arctic-trail/arctic-trail-cam/pi-diode-trailcam/docs/images/real_build/stage2_05_bench_overview_boxes_and_boards.jpg

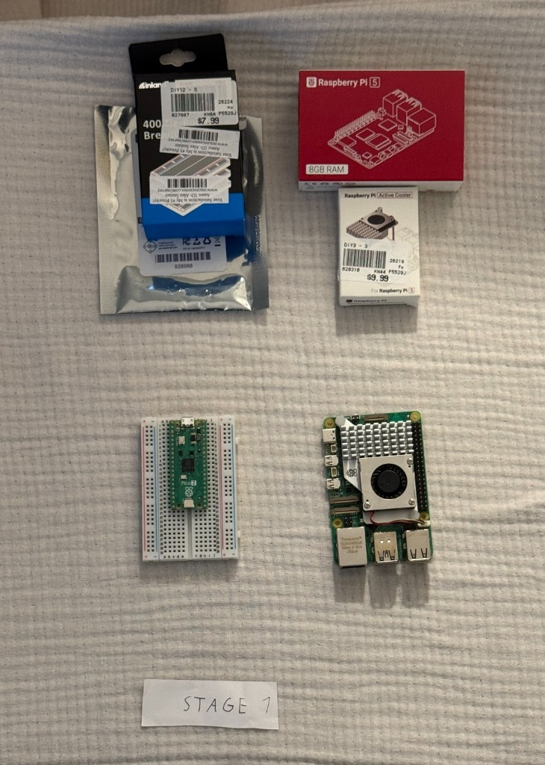
pi-diode-trailcam/docs/images/real_build/stage2_05_bench_overview_boxes_and_boards.jpg
