arctic-trail/arctic-trail-cam/pi-diode-trailcam/hardware/turnkey_assembly_package/BOM-jlcpcb.csv

Comment | Designator | Footprint | LCSC Part #
HT7533-1 30V 3.3V Low-Iq LDO | U1 | SOT-89 | C14289
2x20 Pin 2.54mm Female Socket (for Pico) | U2 | Header-1x20-P2.54mm_x2 | C22557
TPS54560BDDAR 60V 5A Buck | U3 | SOIC-8-EP | C31966
ADS1115IDGSR 16-Bit ADC | U4 | VSSOP-10 | C37593
AO3401A 30V P-FET | Q1 Q3 | SOT-23 | C15127
AOD403 30V 70A High-Side P-FET | Q2A Q2B | TO-252 | C15075
MMBT2222A 40V 600mA NPN Transistor | Q4 Q5 | SOT-23 | C8512
SMBJ15CA 600W TVS Diode | D1 | DO-214AA_SMB | C319205
USBLC6-2SC6 ESD Protection Array | D2 D3 D4 D5 | SOT-23-6 | C7519
SS54-E3 40V 5A Schottky Diode | D6 | DO-214AB_SMC | C22432
10uH 6.5A Shielded Power Inductor | L1 | IND-SMD_10x10mm | C497818
10uF 50V X7R 1206 Ceramic Cap | C1 C2 | C_1206 | C13585
47uF 16V X5R 1206 Ceramic Cap | C3 C4 | C_1206 | C172351
0.1uF 50V X7R 0603 Ceramic Cap | C5 C6 C7 C8 C9 | C_0603 | C14663
10nF 50V X7R 0603 Ceramic Cap | C10 | C_0603 | C1588
10k 1% 0805 Resistor | R1 R6 R7 R8 | R_0805 | C17414
1k 1% 0805 Resistor | R2 R9 R10 | R_0805 | C17513
4.7k 1% 0805 Resistor | R3 R4 | R_0805 | C17673
53.6k 1% 0805 (5.1V Upper FB) | R5 | R_0805 | C17739
100k 1% 0805 (Buck Freq RT) | R11 | R_0805 | C17417
220R 2A Ferrite Bead 0805 | FB1 FB2 FB3 | L_0805 | C1017
Micro-Fit 3.0 2-Pin RA Header | J1 J7 | CONN-TH_2P-P3.00mm | C2892976
Micro-Fit 3.0 4-Pin RA Header | J2 J3 J4 | CONN-TH_4P-P3.00mm | C2892978
USB-C Receptacle High-Power (5V 5A) | J5 | USB-C-SMD | C165948
DC Barrel Jack 2.1x5.5mm SMD | J6 | DC-005_SMD | C136657
2-Pin 5.08mm Screw Terminal | TB1 | TERM-5.08mm-2P | C474952
