arctic-trail/arctic-trail-cam/pi-diode-trailcam/docs/images/real_build/stage1_01_unboxed_parts.jpg

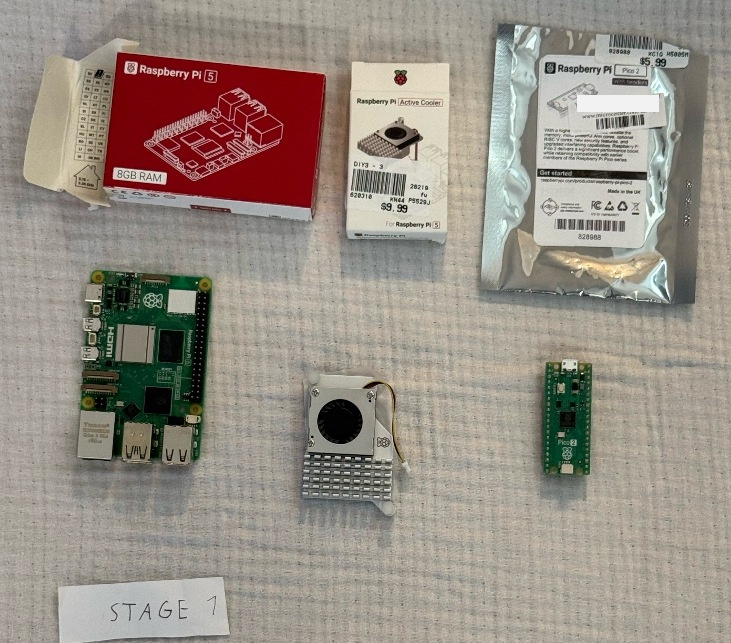
pi-diode-trailcam/docs/images/real_build/stage1_01_unboxed_parts.jpg
