arctic-trail/arctic-trail-cam/pi-diode-trailcam/docs/images/flashing_steps/step01_device_select.png

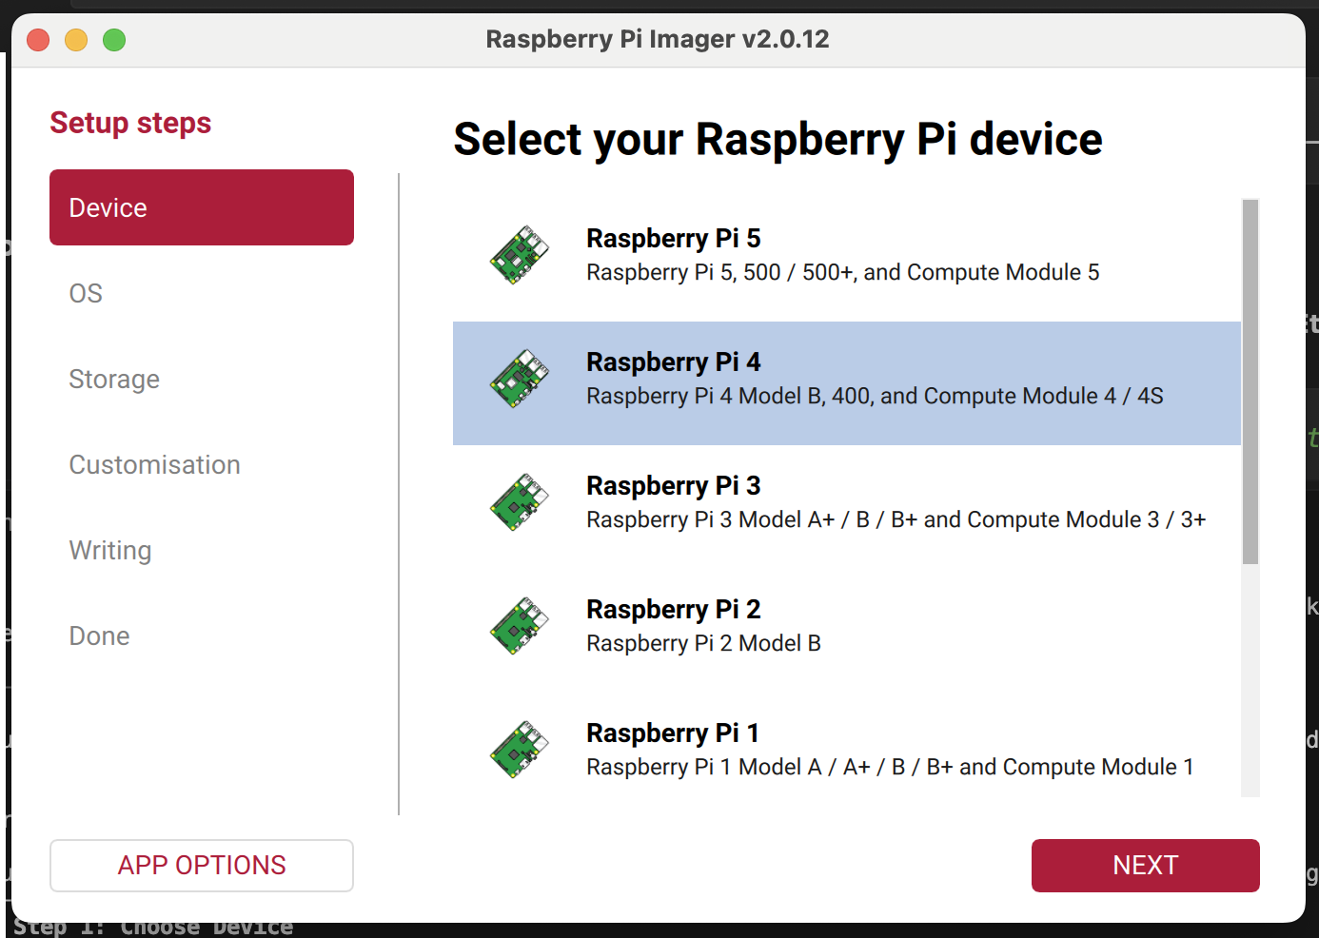
pi-diode-trailcam/docs/images/flashing_steps/step01_device_select.png
