arctic-trail/arctic-trail-cam/pi-diode-trailcam/docs/images/flashing_steps/step02_os_menu.png

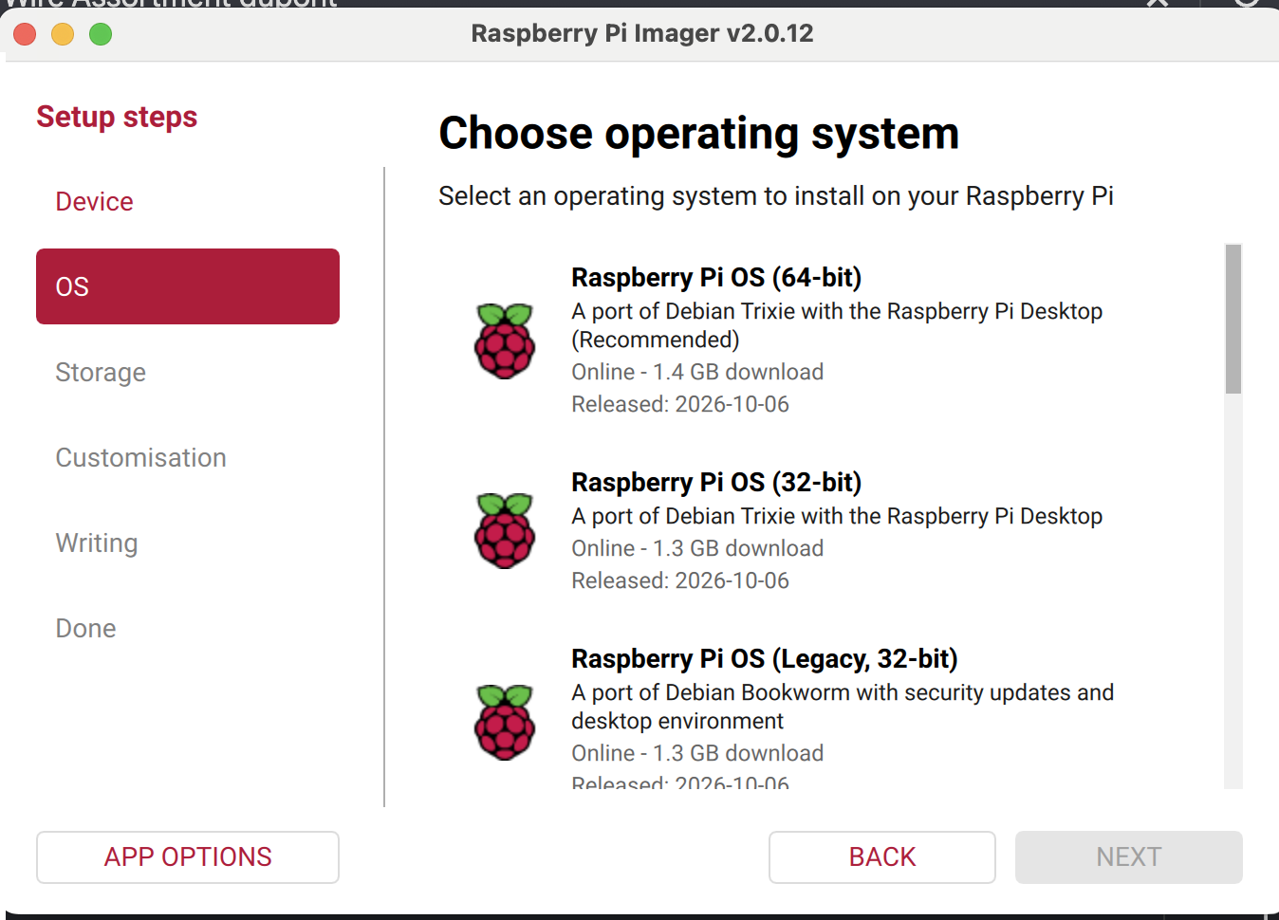
pi-diode-trailcam/docs/images/flashing_steps/step02_os_menu.png
