arctic-trail/arctic-trail-cam/pi-diode-trailcam/docs/images/flashing_steps/step03_os_other.png

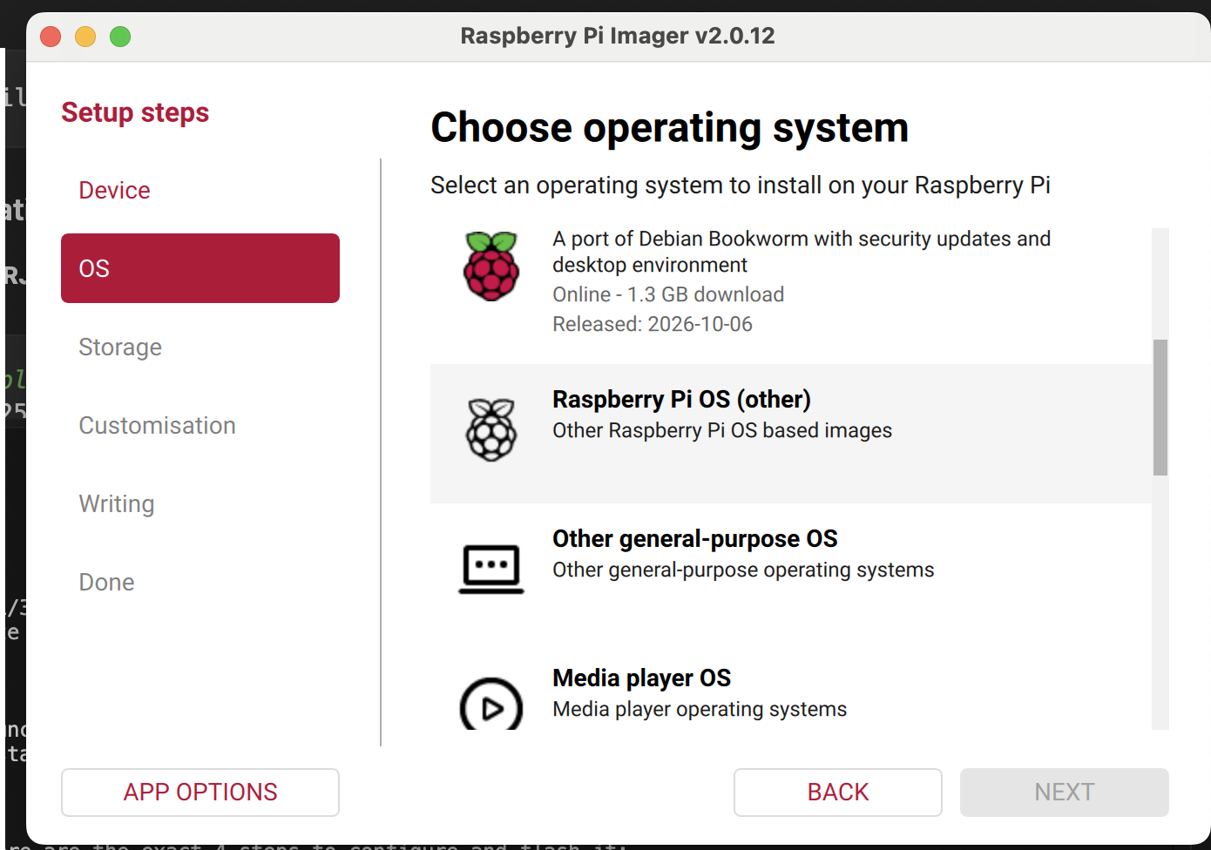
pi-diode-trailcam/docs/images/flashing_steps/step03_os_other.png
