arctic-trail/arctic-trail-cam/pi-diode-trailcam/docs/images/flashing_steps/step04_os_lite_64bit.png

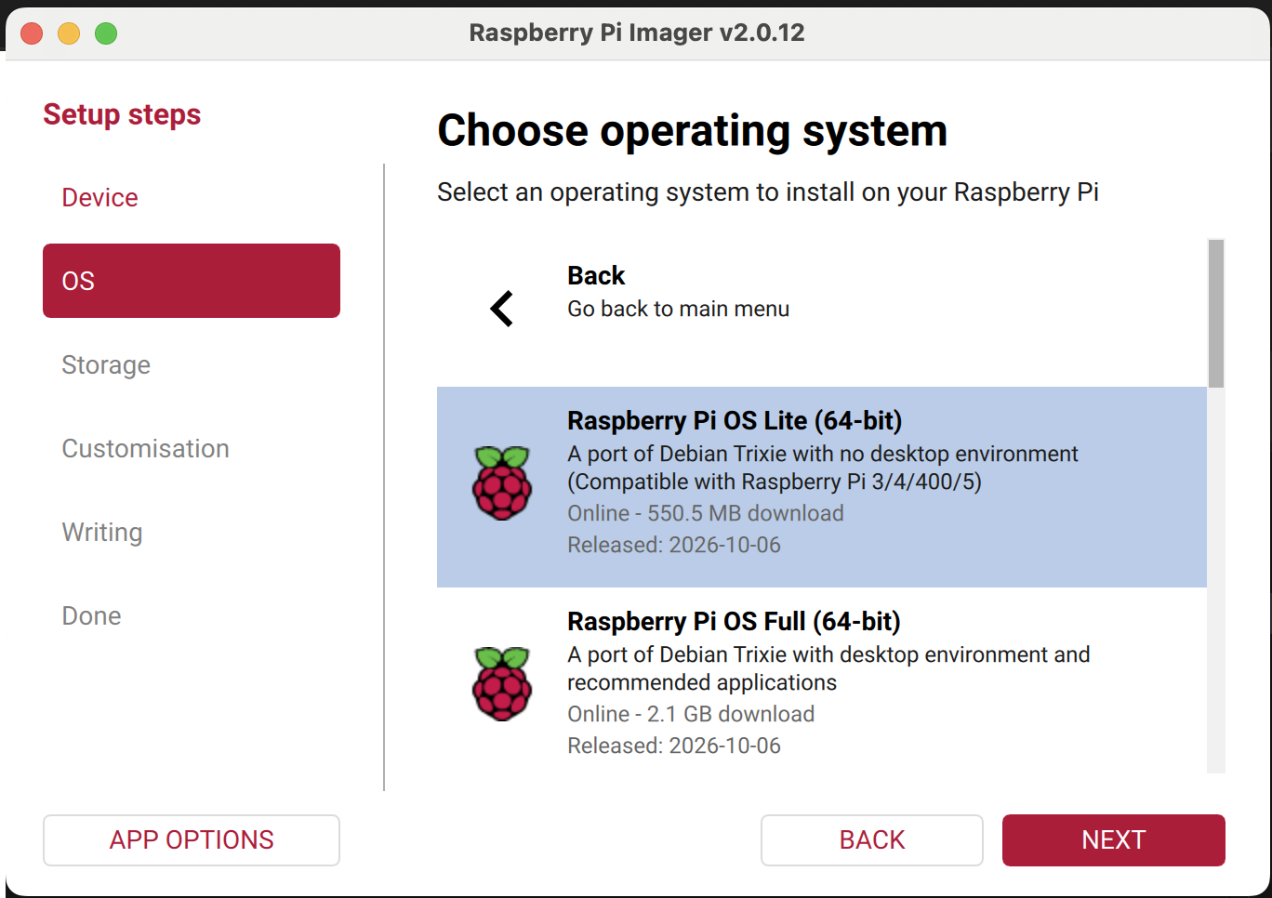
pi-diode-trailcam/docs/images/flashing_steps/step04_os_lite_64bit.png
