arctic-trail/arctic-trail-cam/pi-diode-trailcam/docs/images/flashing_steps/step05_storage_sdxc.png

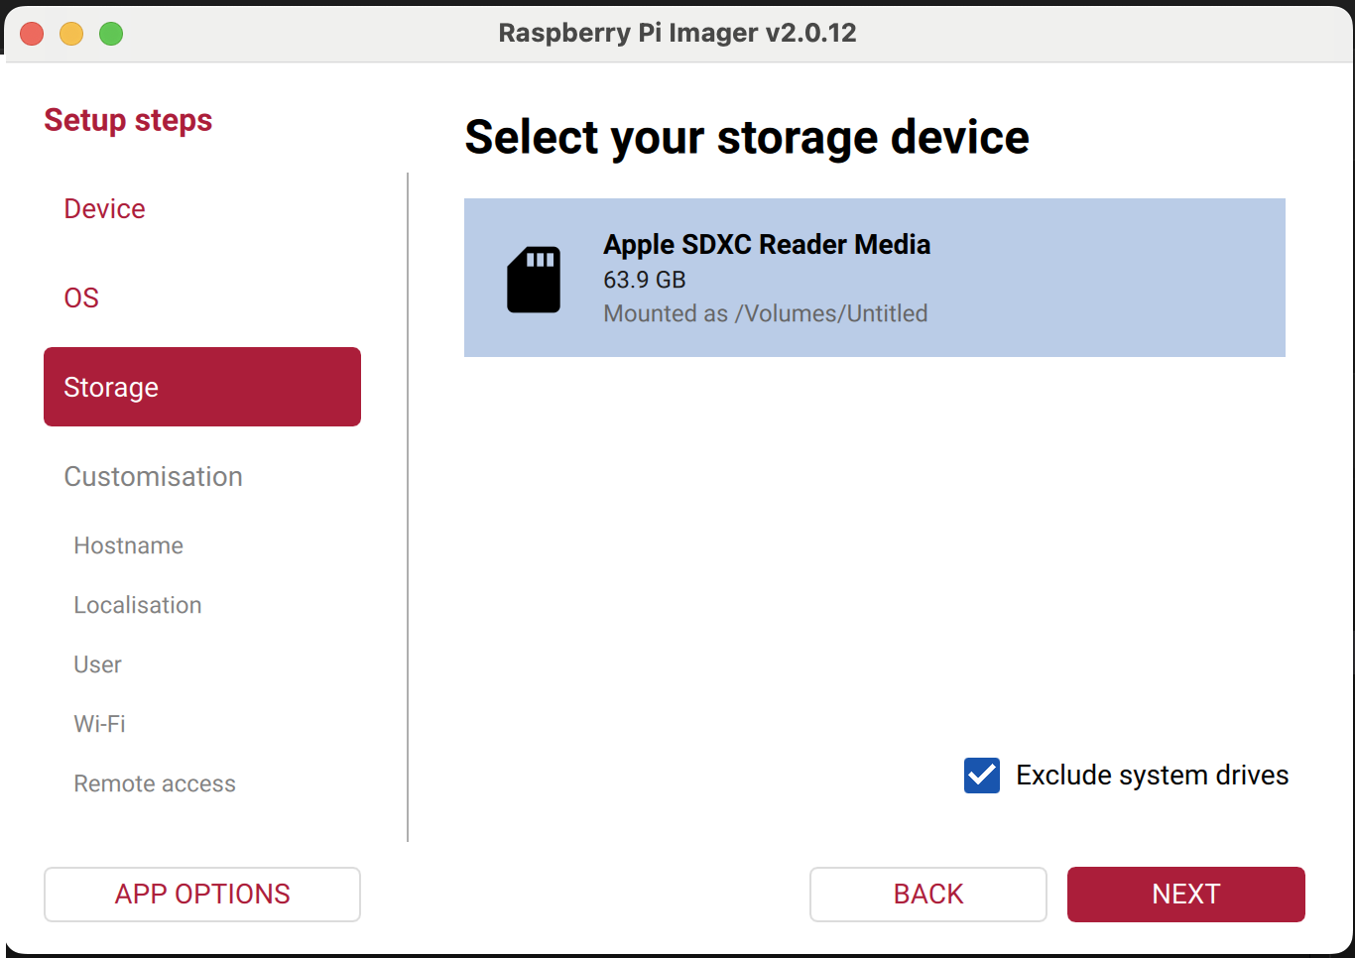
pi-diode-trailcam/docs/images/flashing_steps/step05_storage_sdxc.png
