arctic-trail/arctic-trail-cam/pi-diode-trailcam/docs/images/flashing_steps/step06_hostname_prompt.png

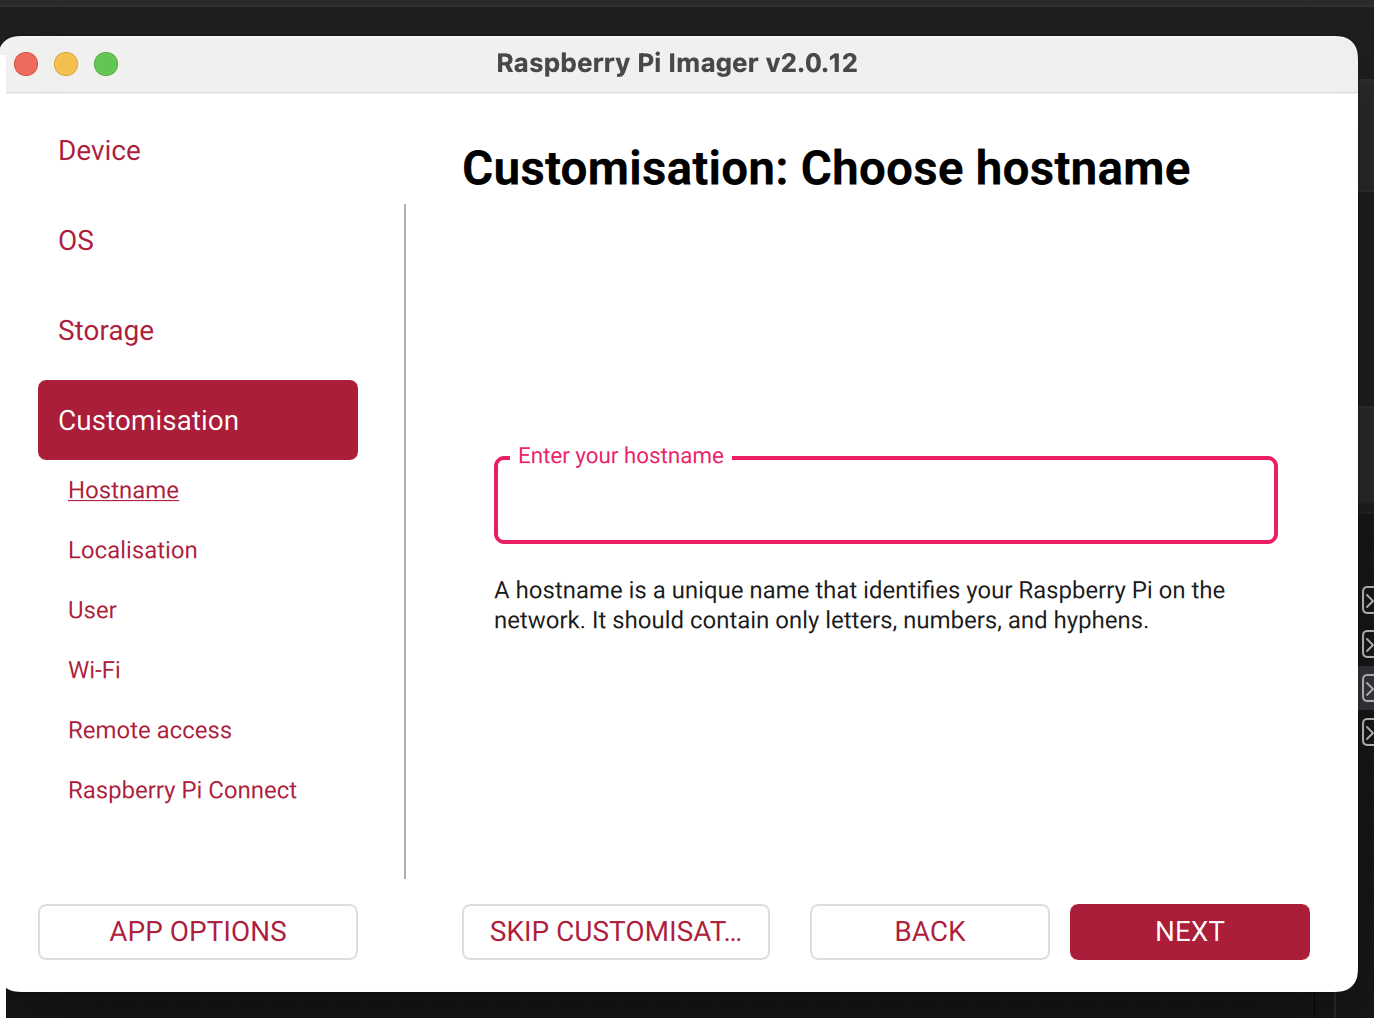
pi-diode-trailcam/docs/images/flashing_steps/step06_hostname_prompt.png
