arctic-trail/arctic-trail-cam/pi-diode-trailcam/docs/images/flashing_steps/step07_hostname_trailcam_node.png

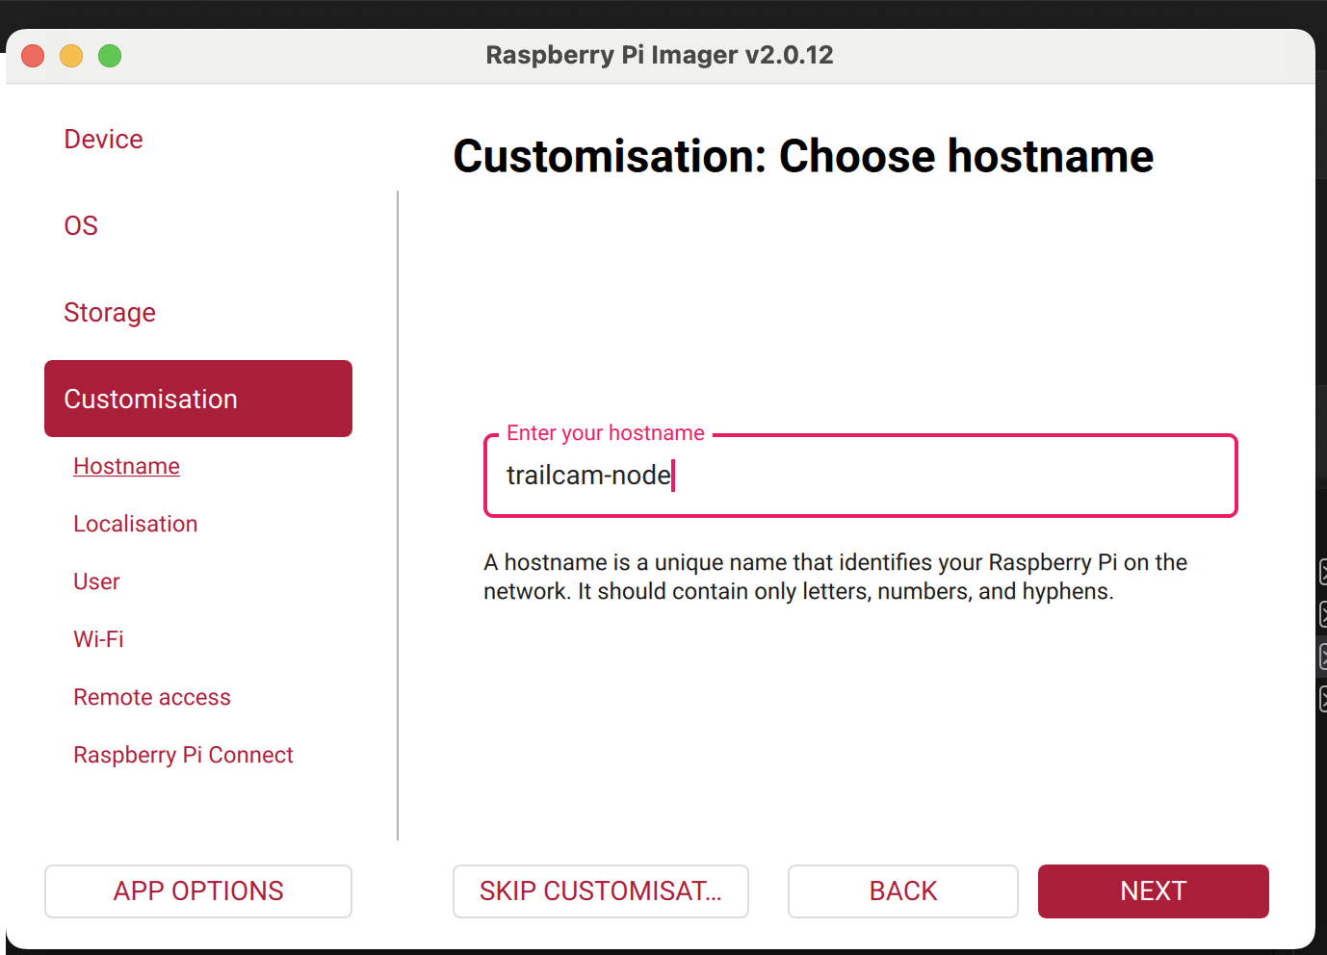
pi-diode-trailcam/docs/images/flashing_steps/step07_hostname_trailcam_node.png
