arctic-trail/arctic-trail-cam/pi-diode-trailcam/docs/images/flashing_steps/step08_localisation_ny.png

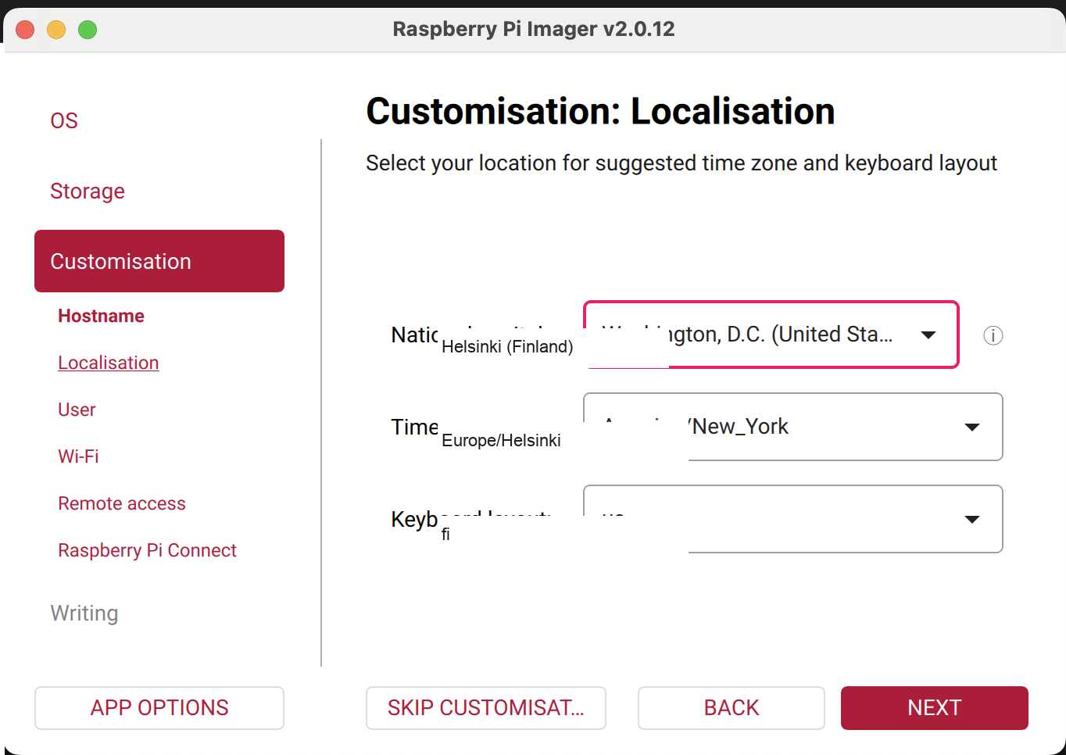
pi-diode-trailcam/docs/images/flashing_steps/step08_localisation_ny.png
