arctic-trail/arctic-trail-cam/pi-diode-trailcam/docs/images/flashing_steps/step09_user_pi.png

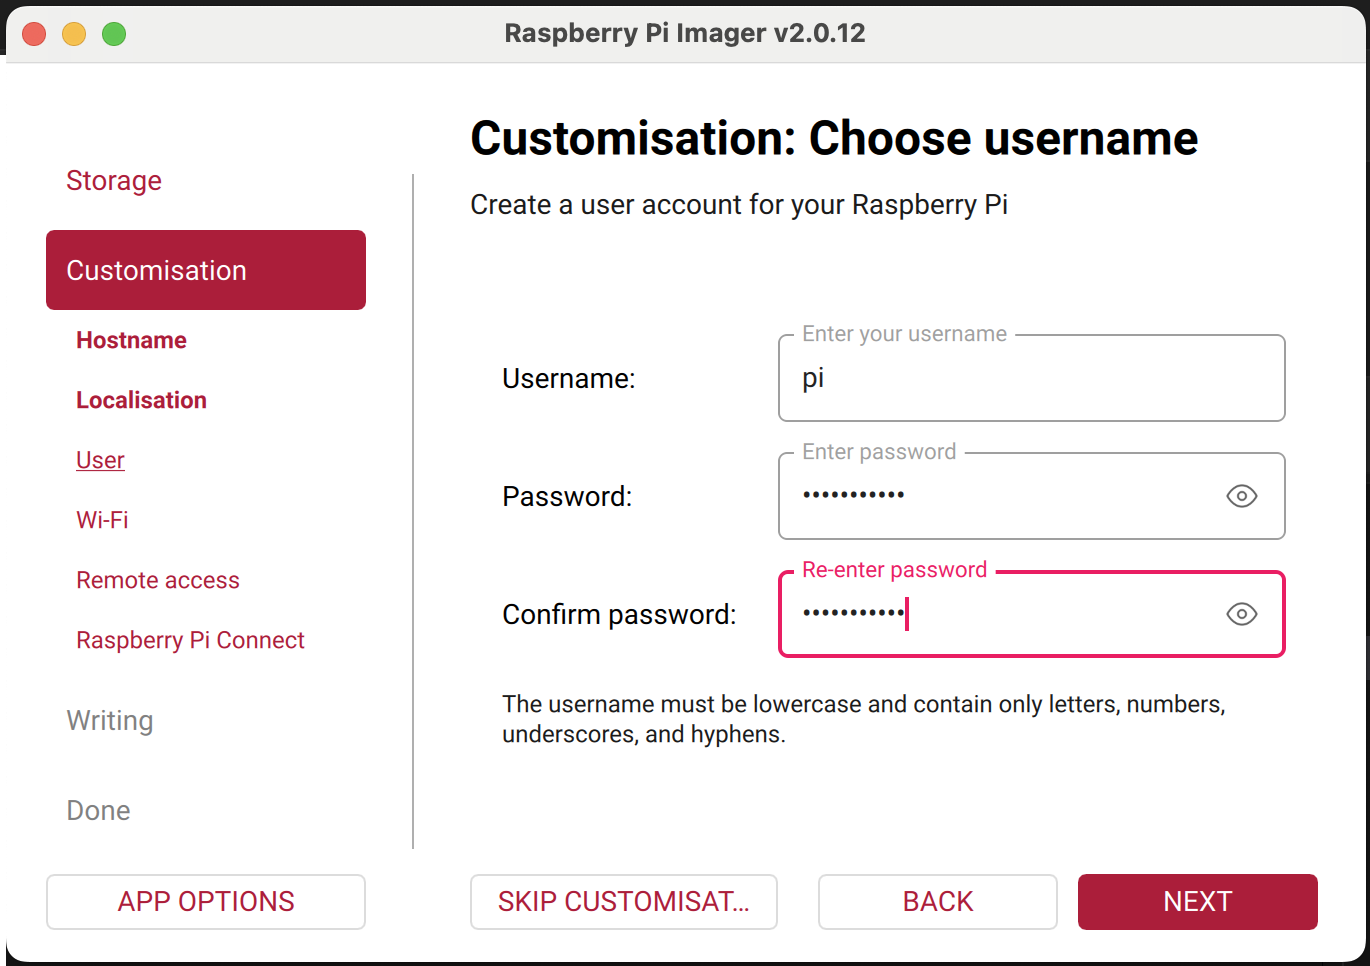
pi-diode-trailcam/docs/images/flashing_steps/step09_user_pi.png
