arctic-trail/arctic-trail-cam/pi-diode-trailcam/docs/images/flashing_steps/step10_wifi_homewifi1.png

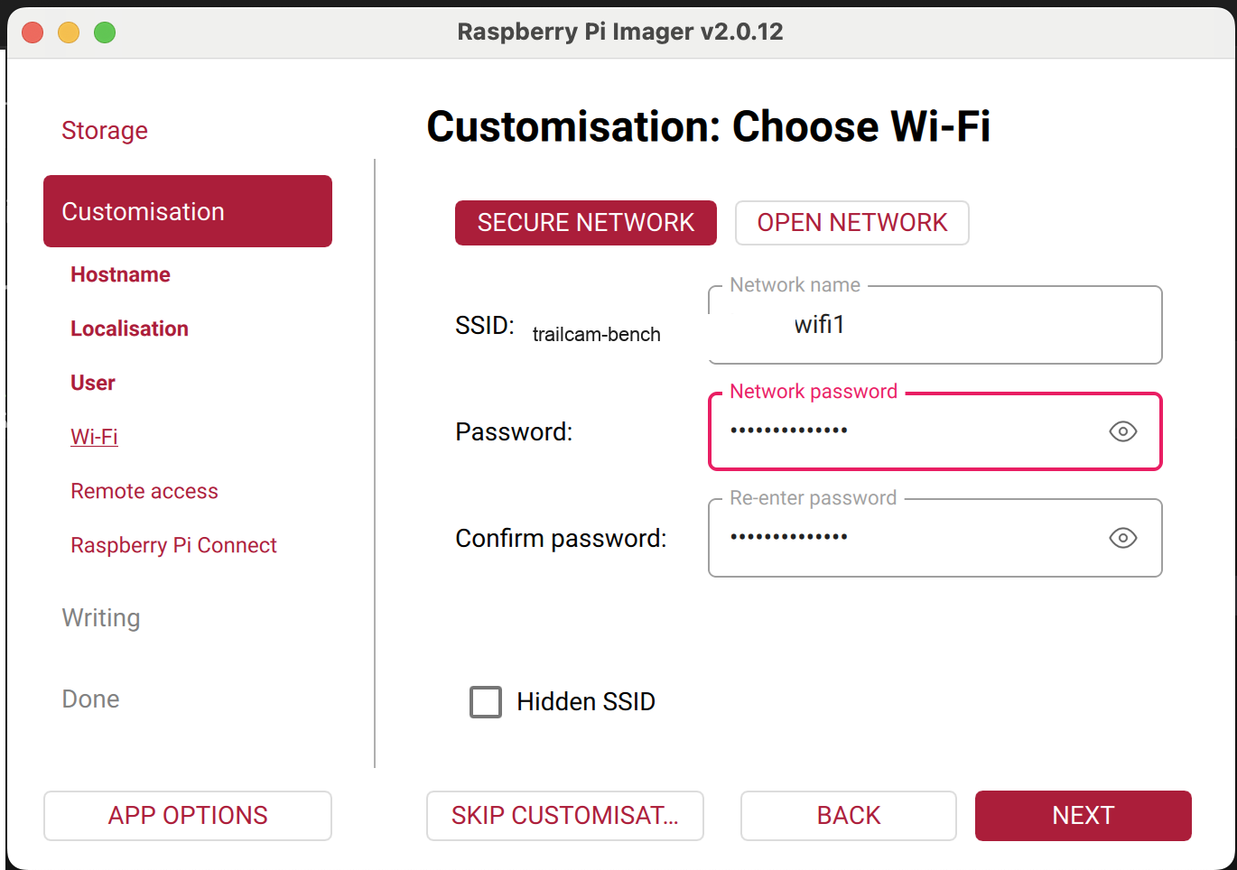
pi-diode-trailcam/docs/images/flashing_steps/step10_wifi_homewifi1.png
