arctic-trail/arctic-trail-cam/pi-diode-trailcam/docs/images/flashing_steps/step11_ssh_enable.png

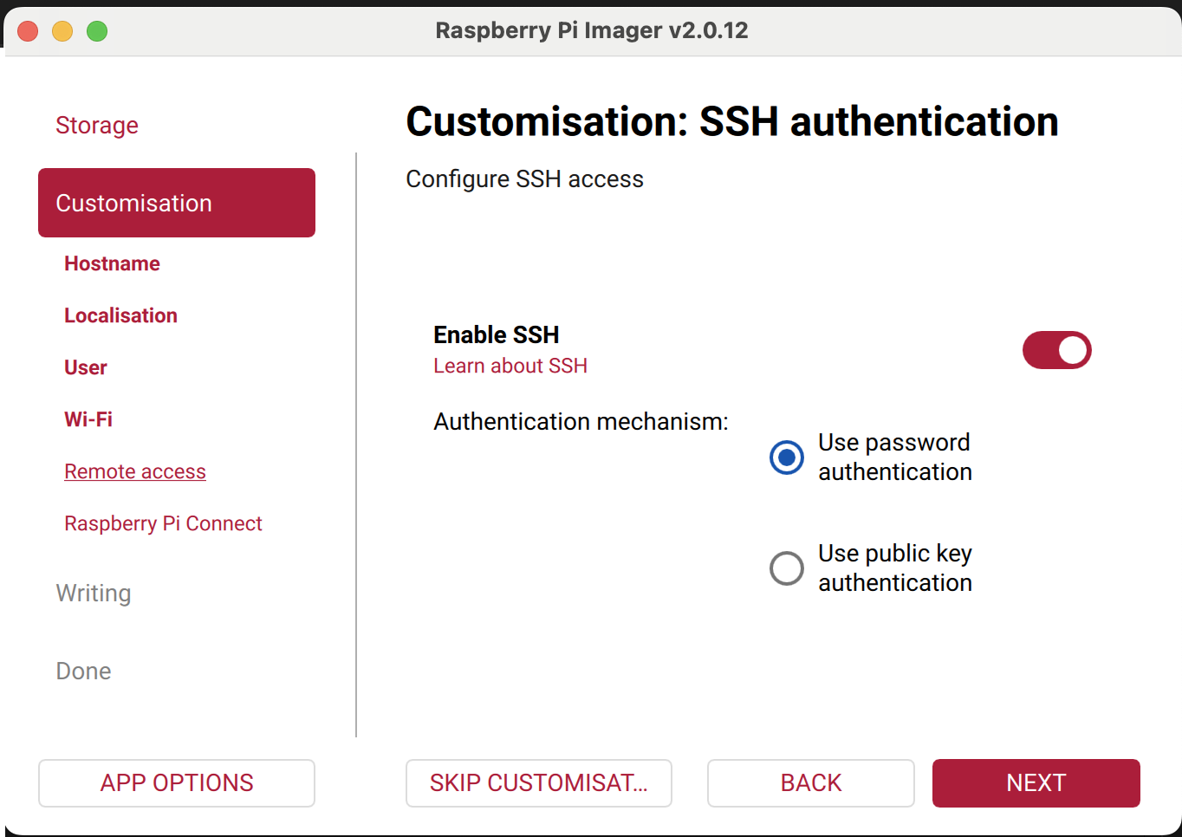
pi-diode-trailcam/docs/images/flashing_steps/step11_ssh_enable.png
