arctic-trail/arctic-trail-cam/pi-diode-trailcam/docs/images/flashing_steps/step12_pi_connect_off.png

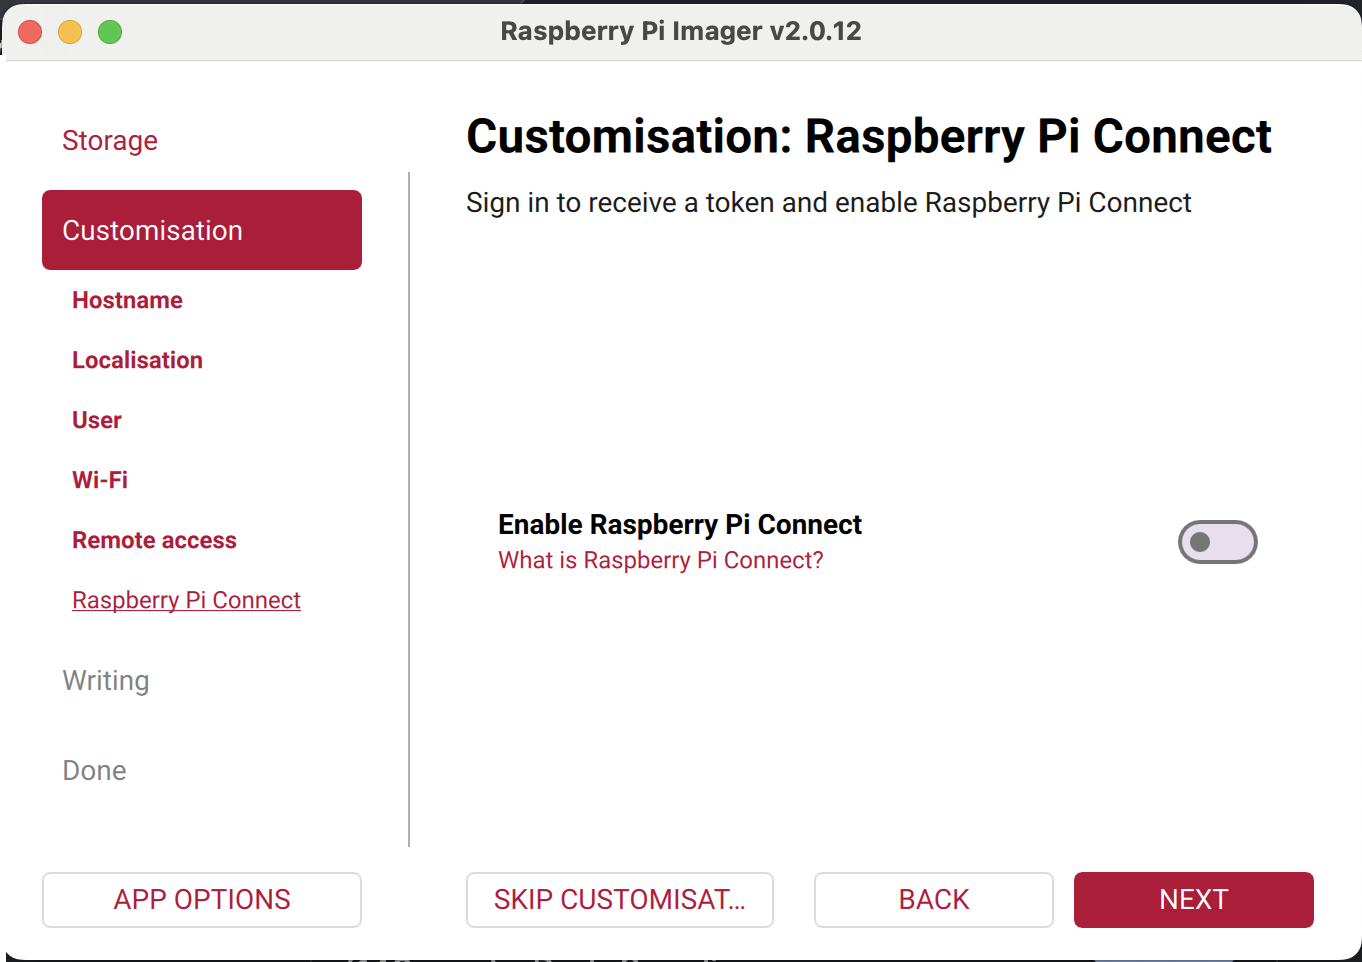
pi-diode-trailcam/docs/images/flashing_steps/step12_pi_connect_off.png
