arctic-trail/arctic-trail-cam/pi-diode-trailcam/docs/images/flashing_steps/step13_write_summary.png

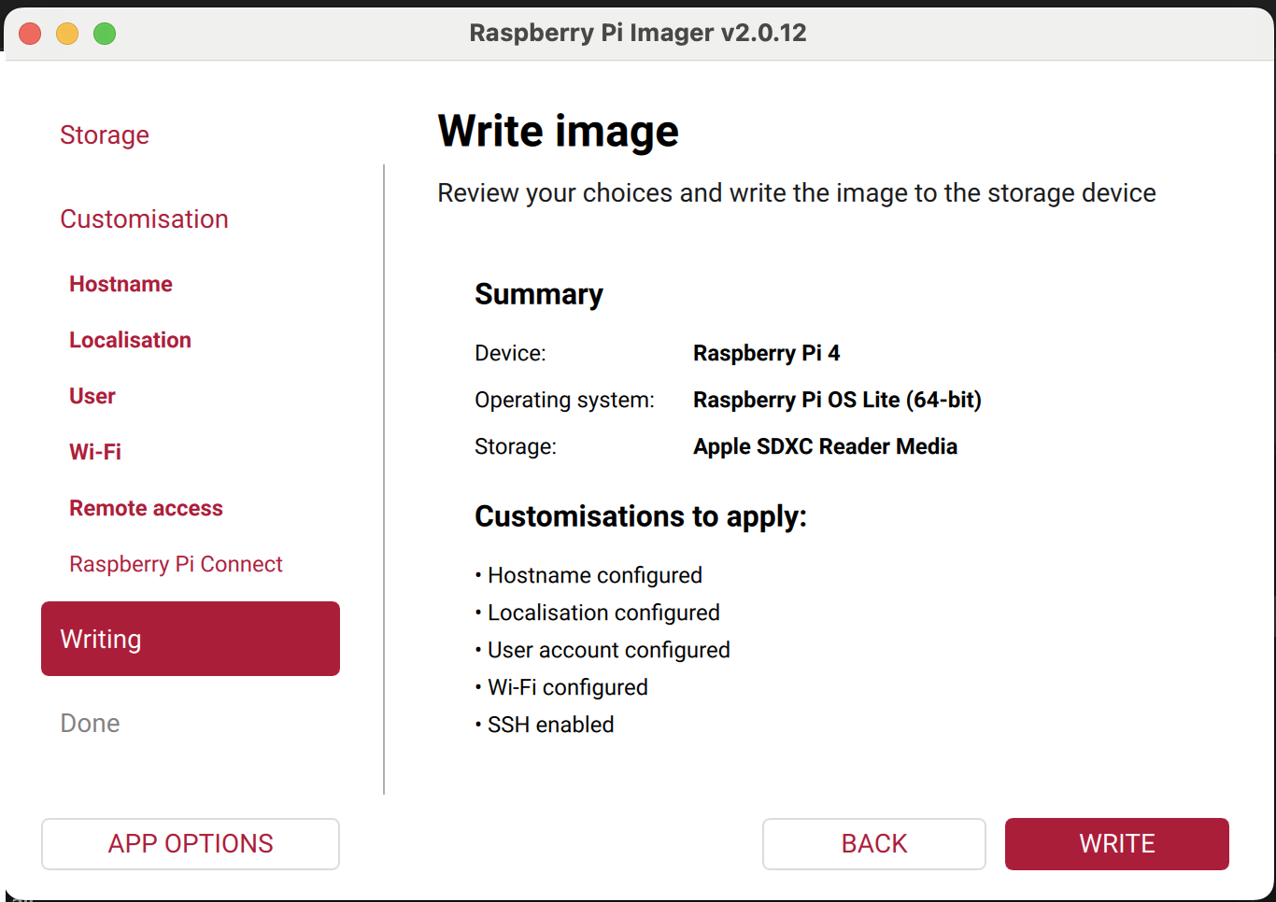
pi-diode-trailcam/docs/images/flashing_steps/step13_write_summary.png
