arctic-trail/arctic-trail-cam/pi-diode-trailcam/docs/images/flashing_steps/step14_erase_confirm.png

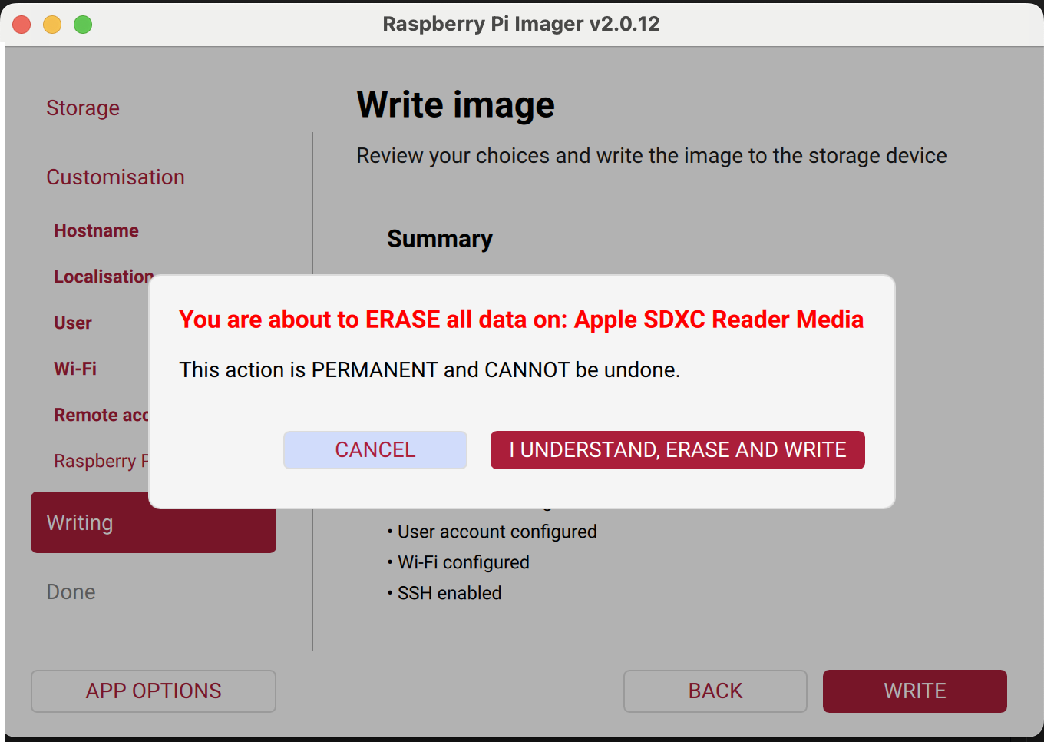
pi-diode-trailcam/docs/images/flashing_steps/step14_erase_confirm.png
