arctic-trail/arctic-trail-cam/pi-diode-trailcam/docs/images/flashing_steps/step15_macos_permission_allow.png

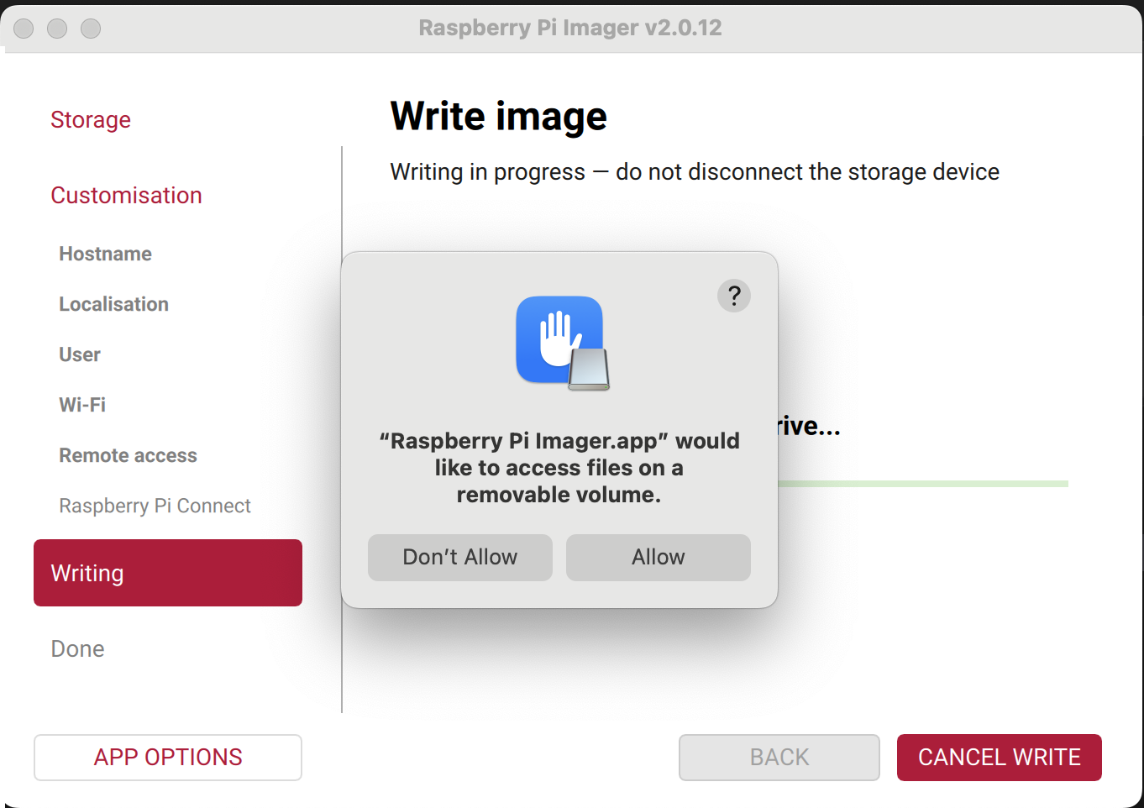
pi-diode-trailcam/docs/images/flashing_steps/step15_macos_permission_allow.png
