arctic-trail/arctic-trail-cam/pi-diode-trailcam/docs/images/flashing_steps/step16_writing_progress.png

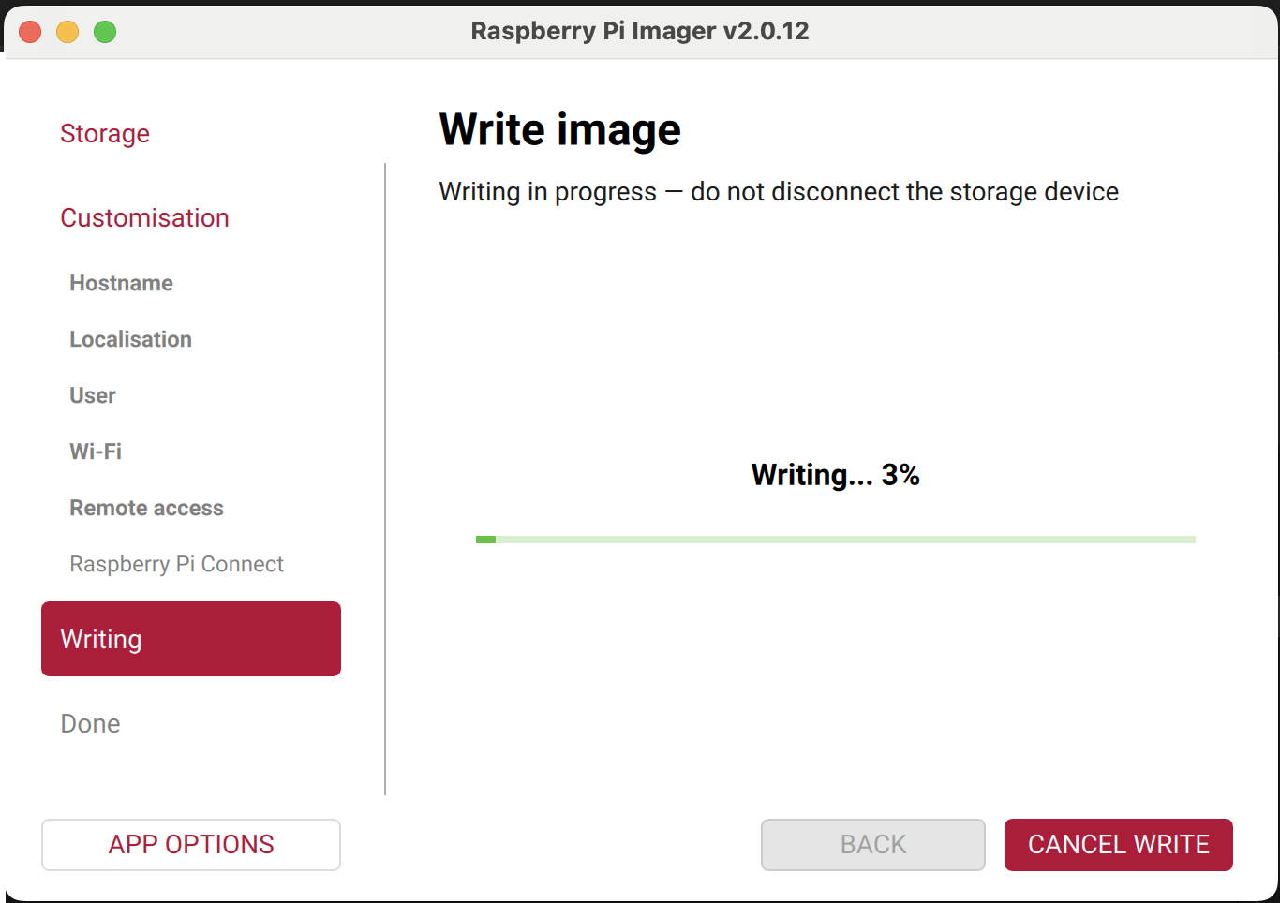
pi-diode-trailcam/docs/images/flashing_steps/step16_writing_progress.png
