arctic-trail/arctic-trail-cam/pi-diode-trailcam/docs/images/flashing_steps/step17_write_complete.png

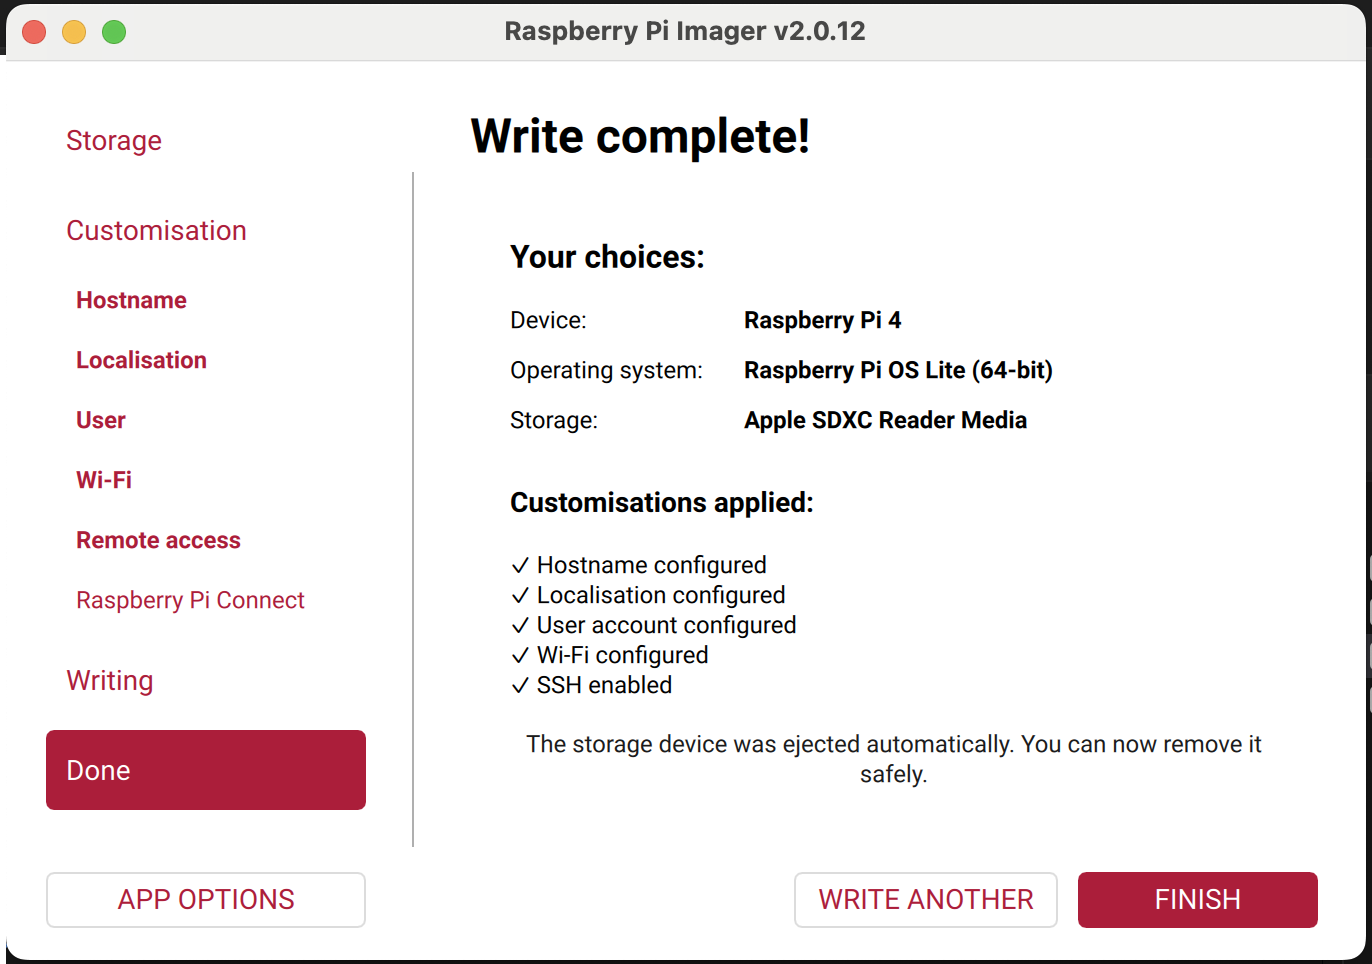
pi-diode-trailcam/docs/images/flashing_steps/step17_write_complete.png
