arctic-trail/arctic-trail-cam/pi-diode-trailcam/docs/images/real_build/stage1_02_peeling_thermal_film.jpg

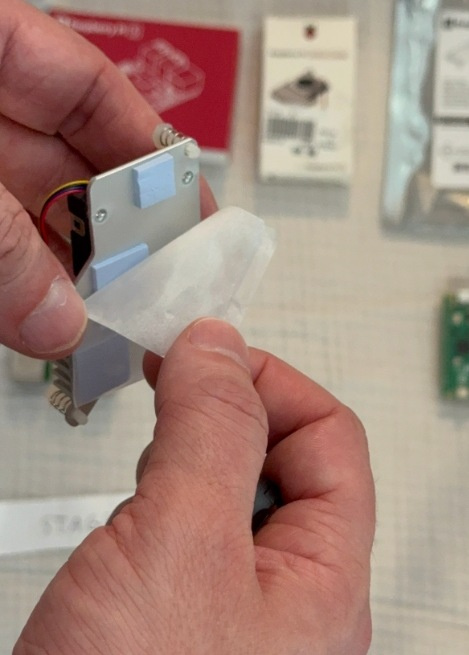
pi-diode-trailcam/docs/images/real_build/stage1_02_peeling_thermal_film.jpg
