arctic-trail/arctic-trail-cam/pi-diode-trailcam/docs/images/real_build/stage1_03_cooler_top_alignment.jpg

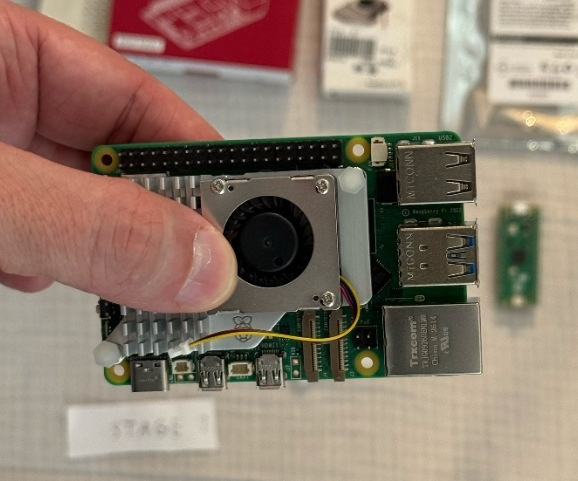
pi-diode-trailcam/docs/images/real_build/stage1_03_cooler_top_alignment.jpg
