arctic-trail/arctic-trail-cam/pi-diode-trailcam/docs/images/real_build/stage1_04_hdmi_camdisp_clearance.jpg

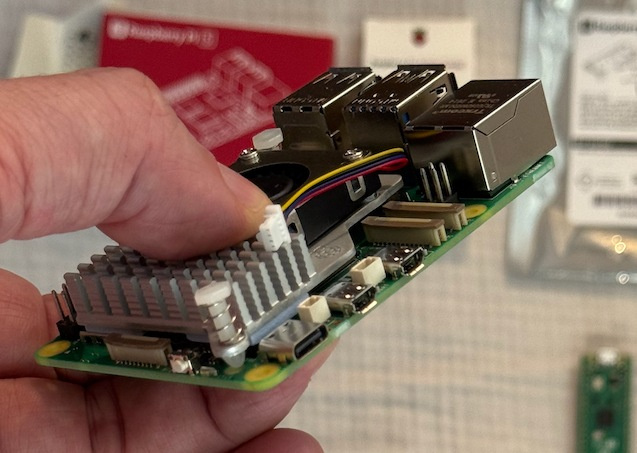
pi-diode-trailcam/docs/images/real_build/stage1_04_hdmi_camdisp_clearance.jpg
