arctic-trail/arctic-trail-cam/pi-diode-trailcam/docs/images/real_build/stage1_05_gpio_side_profile_pins_locked.jpg

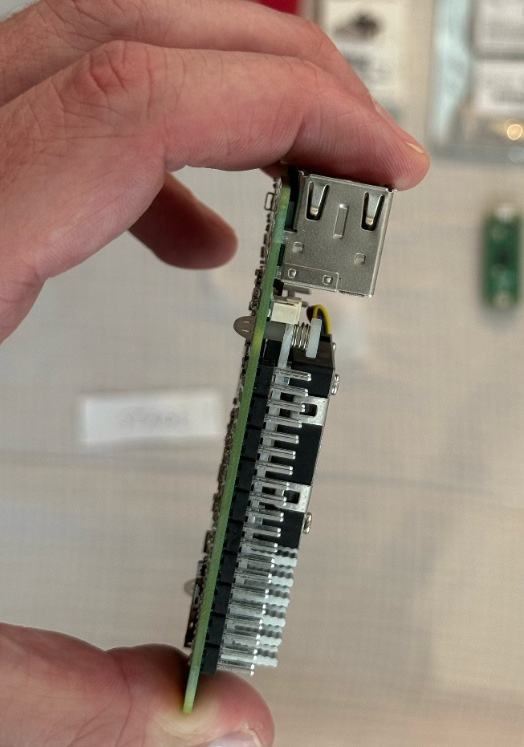
pi-diode-trailcam/docs/images/real_build/stage1_05_gpio_side_profile_pins_locked.jpg
