arctic-trail/arctic-trail-cam/pi-diode-trailcam/docs/images/real_build/stage1_06_ports_edge_profile.jpg

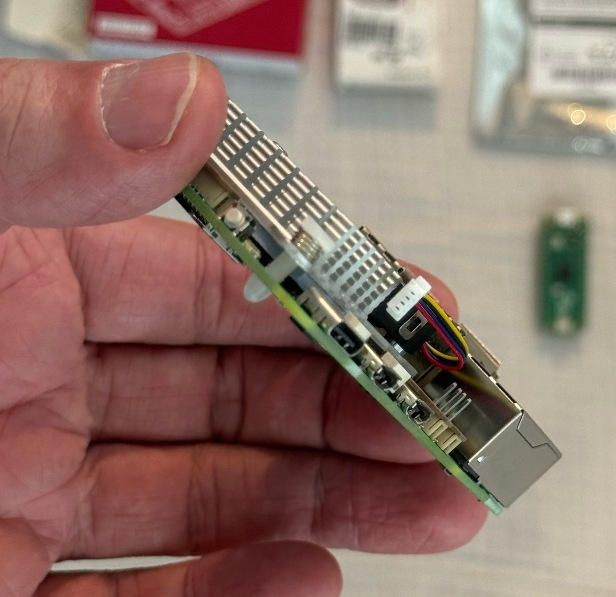
pi-diode-trailcam/docs/images/real_build/stage1_06_ports_edge_profile.jpg
