arctic-trail/arctic-trail-cam/pi-diode-trailcam/docs/images/real_build/stage1_07_fan_socket_j11_closeup.jpg

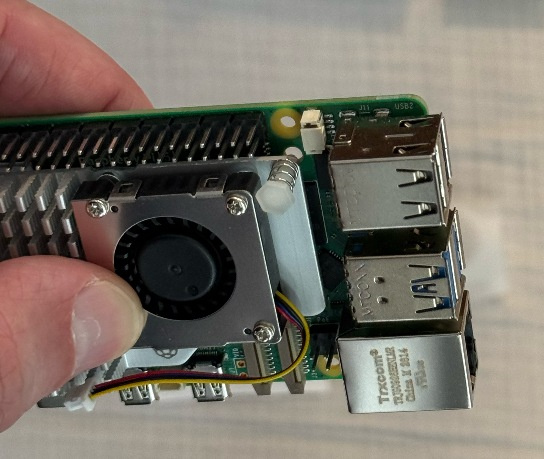
pi-diode-trailcam/docs/images/real_build/stage1_07_fan_socket_j11_closeup.jpg
