arctic-trail/arctic-trail-cam/pi-diode-trailcam/docs/images/real_build/stage1_07b_pointing_at_j11_dust_cap.jpg

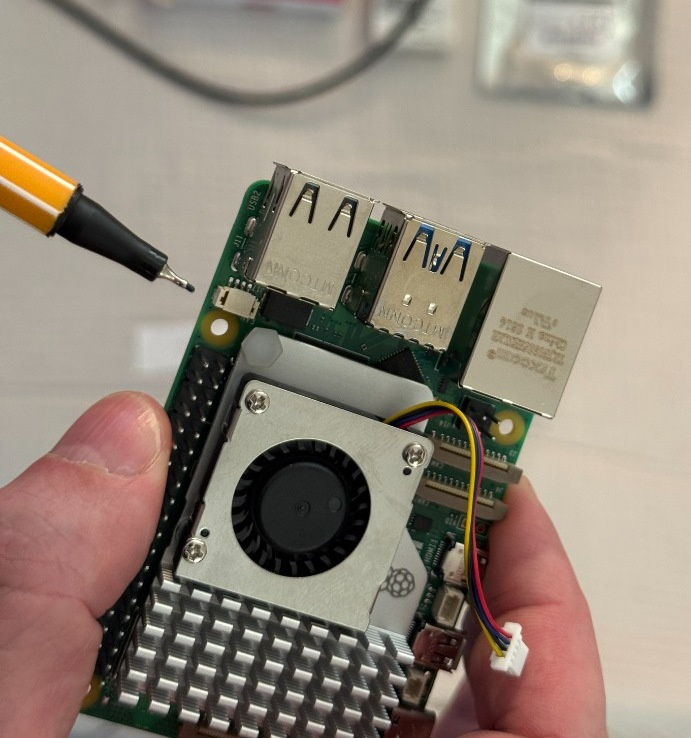
pi-diode-trailcam/docs/images/real_build/stage1_07b_pointing_at_j11_dust_cap.jpg
