arctic-trail/arctic-trail-cam/pi-diode-trailcam/docs/images/real_build/stage1_07c_prying_j11_dust_cap.jpg

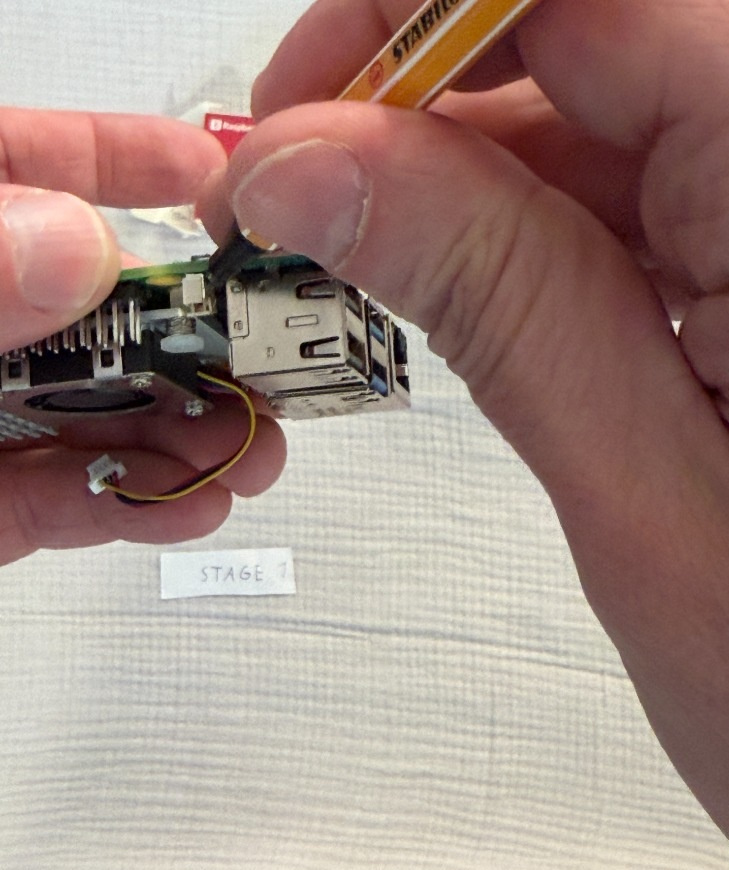
pi-diode-trailcam/docs/images/real_build/stage1_07c_prying_j11_dust_cap.jpg
