arctic-trail/arctic-trail-cam/pi-diode-trailcam/docs/images/real_build/stage1_07d_j11_cap_removed_socket_open.jpg

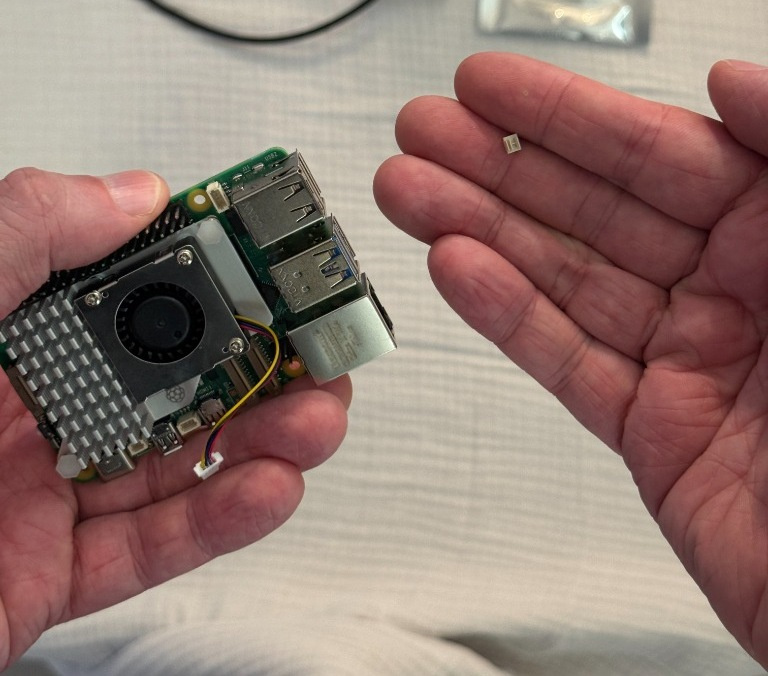
pi-diode-trailcam/docs/images/real_build/stage1_07d_j11_cap_removed_socket_open.jpg
