arctic-trail/arctic-trail-cam/pi-diode-trailcam/docs/images/real_build/stage1_07e_fan_cable_plugged_into_j11.jpg

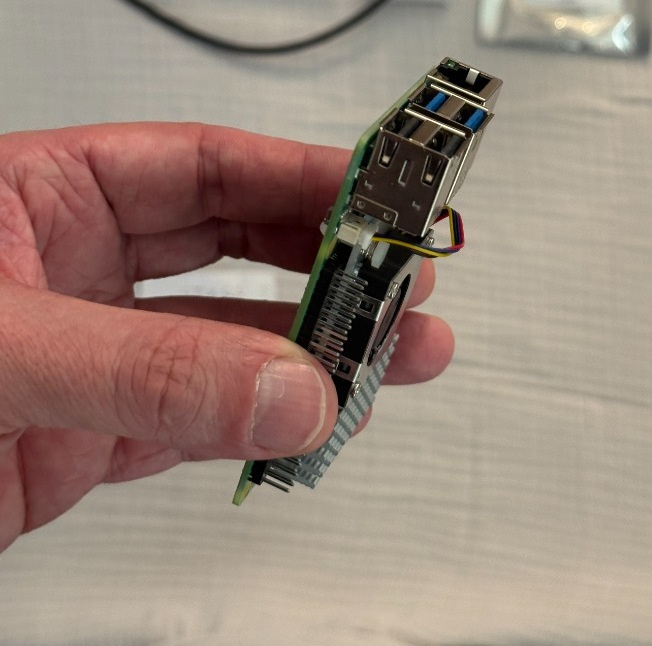
pi-diode-trailcam/docs/images/real_build/stage1_07e_fan_cable_plugged_into_j11.jpg
