arctic-trail/arctic-trail-cam/pi-diode-trailcam/docs/images/real_build/stage1_08_pico2_micro_usb_alignment.jpg

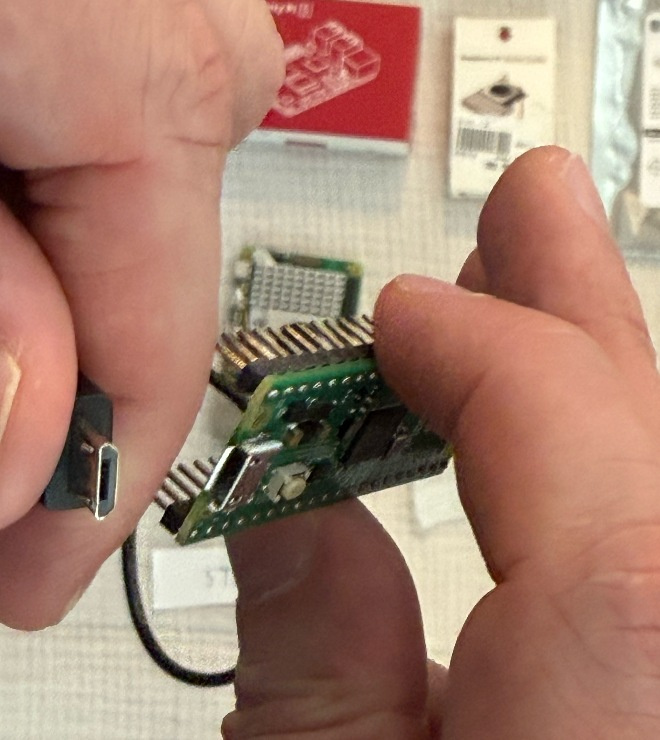
pi-diode-trailcam/docs/images/real_build/stage1_08_pico2_micro_usb_alignment.jpg
