arctic-trail/arctic-trail-cam/pi-diode-trailcam/docs/images/real_build/stage1_09_pico2_top_bootsel_view.jpg

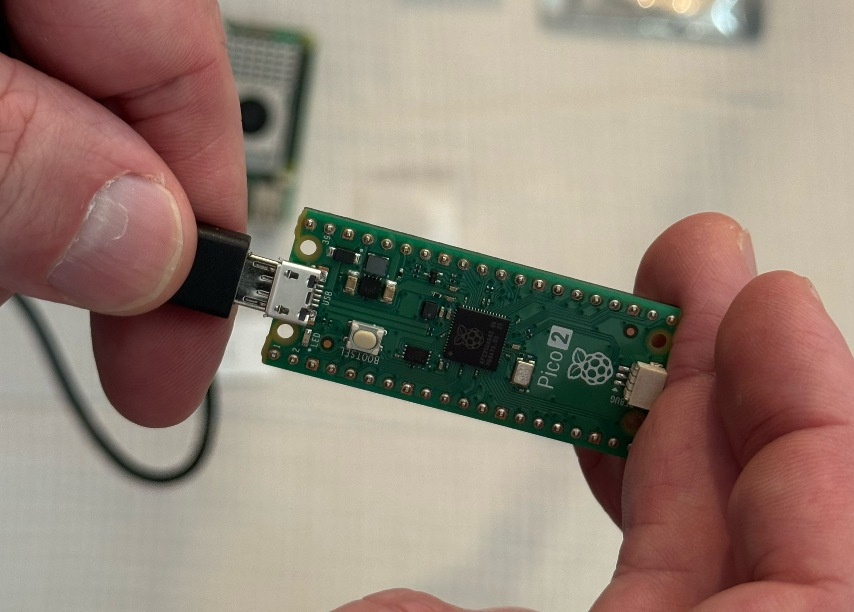
pi-diode-trailcam/docs/images/real_build/stage1_09_pico2_top_bootsel_view.jpg
