arctic-trail/arctic-trail-cam/pi-diode-trailcam/docs/images/real_build/stage1_10_pico2_40pin_header_profile_closeup.jpg

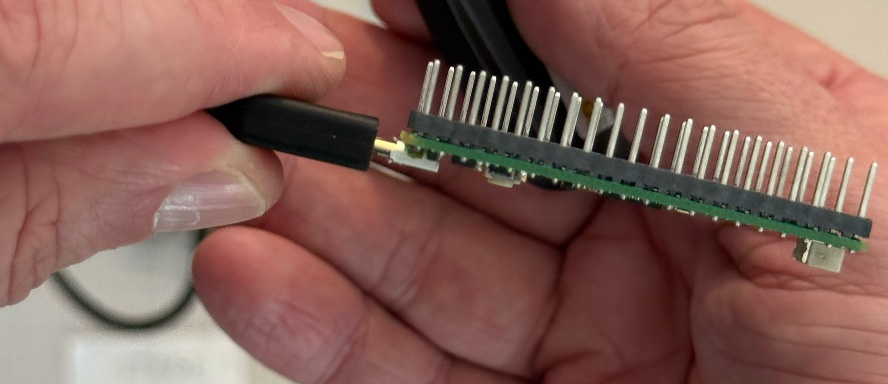
pi-diode-trailcam/docs/images/real_build/stage1_10_pico2_40pin_header_profile_closeup.jpg
