arctic-trail/arctic-trail-cam/pi-diode-trailcam/docs/images/real_build/stage1_11_pico2_side_profile_over_stage1_bench.jpg

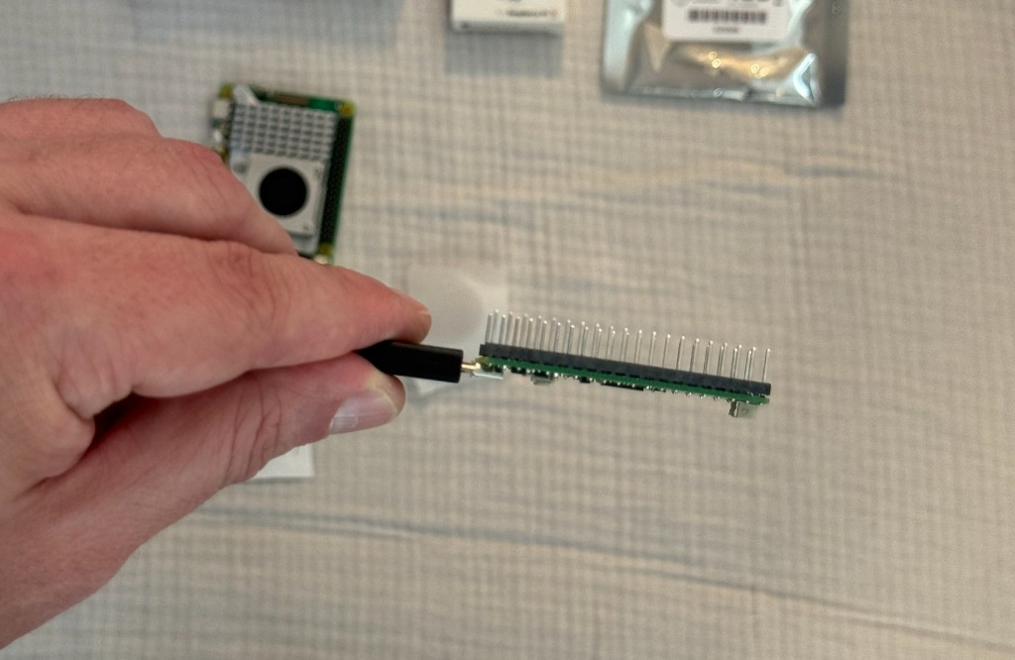
pi-diode-trailcam/docs/images/real_build/stage1_11_pico2_side_profile_over_stage1_bench.jpg
