arctic-trail/arctic-trail-cam/pi-diode-trailcam/docs/images/real_build/stage1_12_micro_usb_to_usb_a_cord_both_ends.jpg

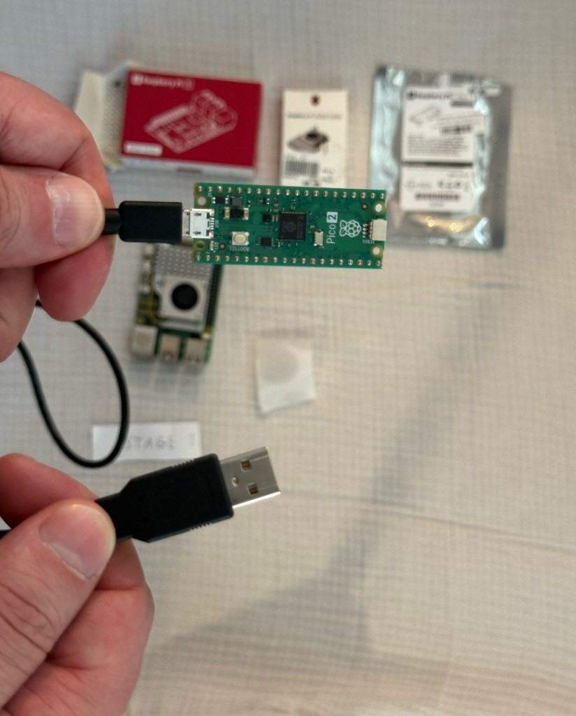
pi-diode-trailcam/docs/images/real_build/stage1_12_micro_usb_to_usb_a_cord_both_ends.jpg
