arctic-trail/arctic-trail-cam/pi-diode-trailcam/docs/images/real_build/stage1_13_usb_c_adapter_in_macbook_pro.jpg

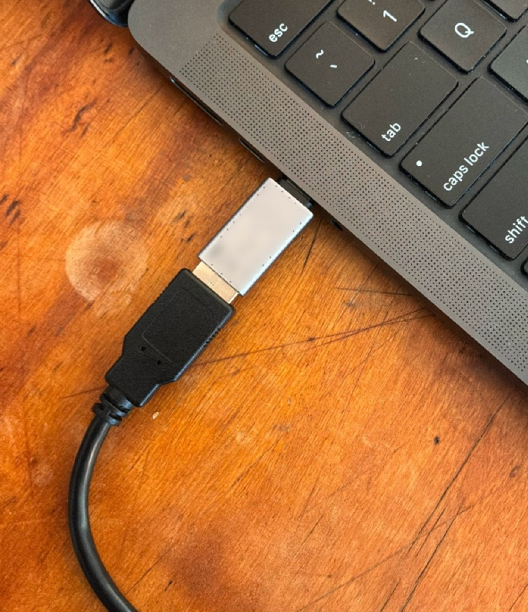
pi-diode-trailcam/docs/images/real_build/stage1_13_usb_c_adapter_in_macbook_pro.jpg
