arctic-trail/arctic-trail-cam/pi-diode-trailcam/docs/images/real_build/stage1_14_pressing_bootsel_button.jpg

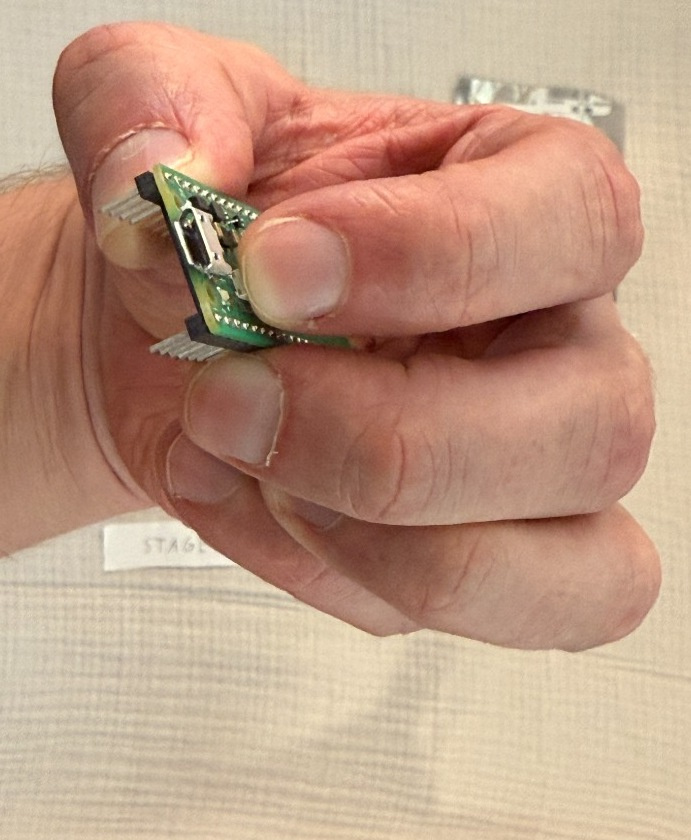
pi-diode-trailcam/docs/images/real_build/stage1_14_pressing_bootsel_button.jpg
