arctic-trail/arctic-trail-cam/pi-diode-trailcam/docs/images/real_build/stage1_15_plugging_cord_while_holding_bootsel.jpg

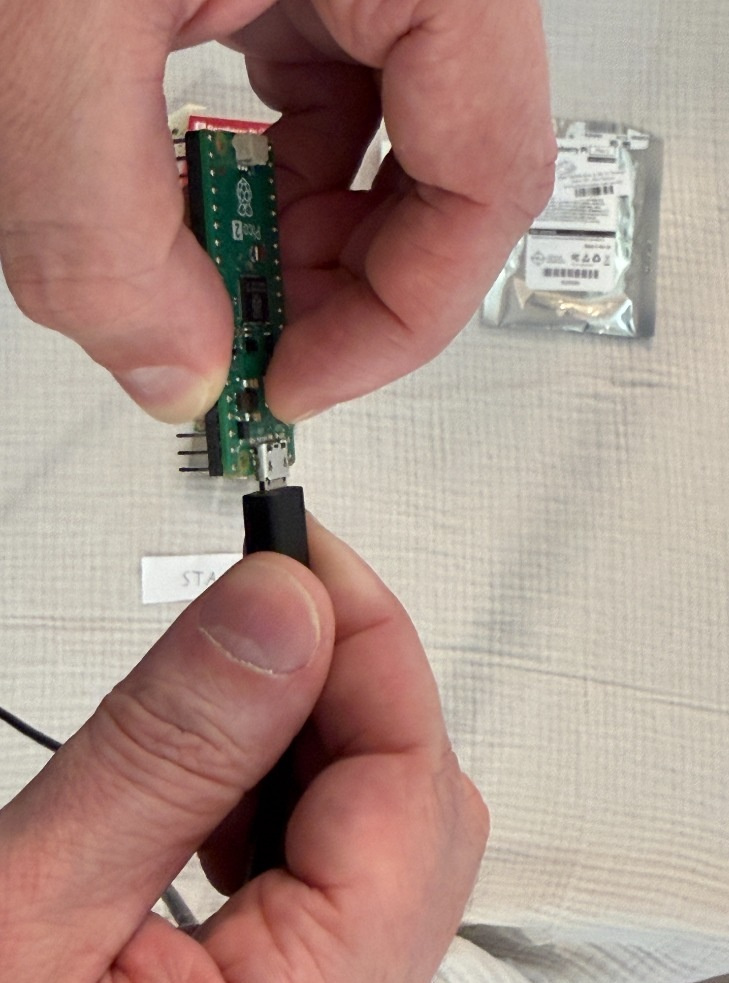
pi-diode-trailcam/docs/images/real_build/stage1_15_plugging_cord_while_holding_bootsel.jpg
