arctic-trail/arctic-trail-cam/pi-diode-trailcam/docs/images/real_build/stage2_01_empty_breadboard_30rows.jpg

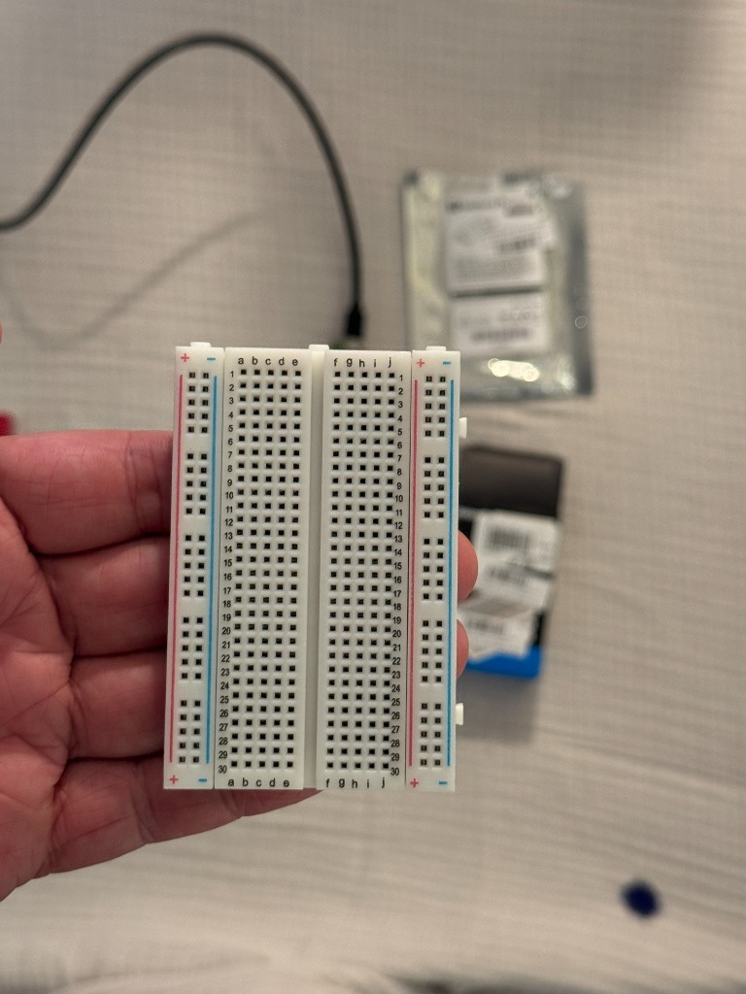
pi-diode-trailcam/docs/images/real_build/stage2_01_empty_breadboard_30rows.jpg
