arctic-trail/arctic-trail-cam/pi-diode-trailcam/docs/images/real_build/stage2_02_pico2_top_alignment_rows1_to_20.jpg

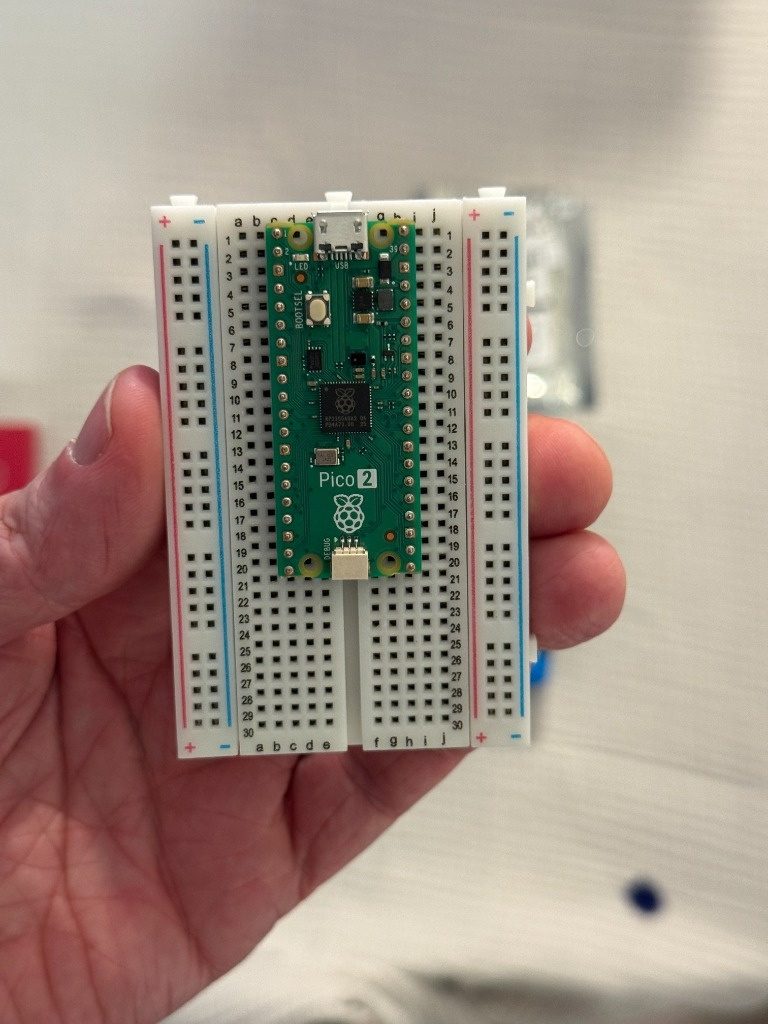
pi-diode-trailcam/docs/images/real_build/stage2_02_pico2_top_alignment_rows1_to_20.jpg
