arctic-trail/arctic-trail-cam/pi-diode-trailcam/docs/images/real_build/stage2_03_pico2_angled_seated_in_breadboard.jpg

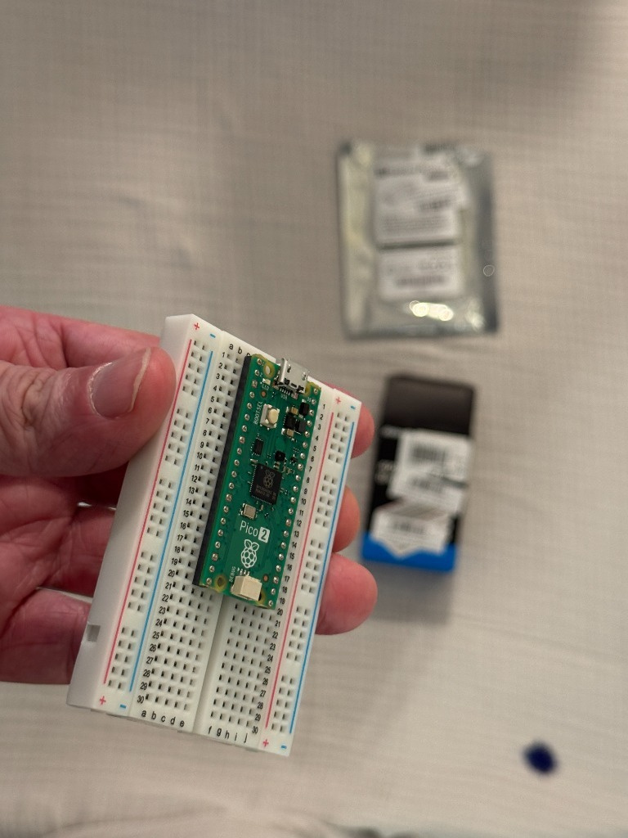
pi-diode-trailcam/docs/images/real_build/stage2_03_pico2_angled_seated_in_breadboard.jpg
