arctic-trail/arctic-trail-cam/pi-diode-trailcam/docs/images/real_build/stage2_04_pico2_side_profile_flush_on_breadboard.jpg

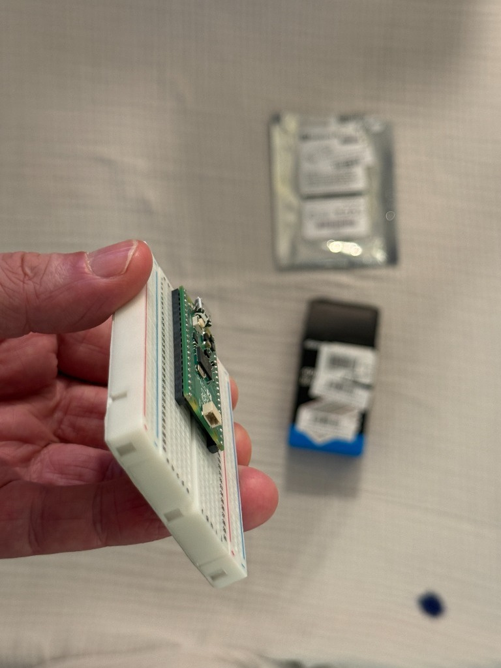
pi-diode-trailcam/docs/images/real_build/stage2_04_pico2_side_profile_flush_on_breadboard.jpg
