arctic-trail/arctic-trail-cam/pi-diode-trailcam/docs/images/real_build/stage2_06_topdown_breadboard_pico2_next_to_pi5.jpg

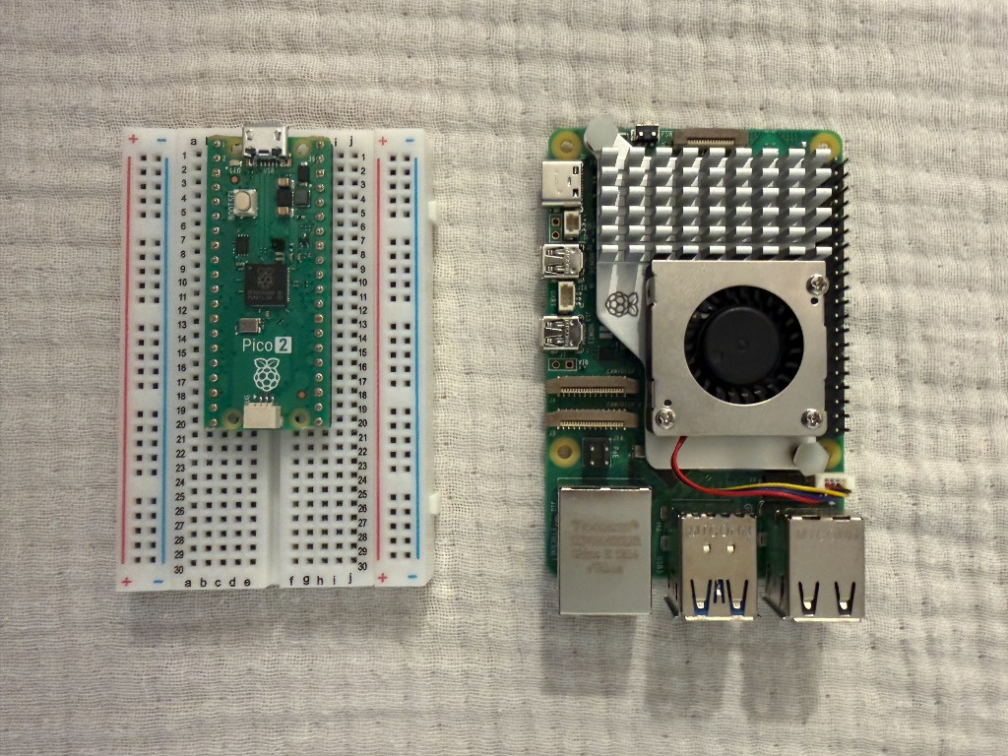
pi-diode-trailcam/docs/images/real_build/stage2_06_topdown_breadboard_pico2_next_to_pi5.jpg
