arctic-trail/arctic-trail-cam/pi-diode-trailcam/docs/images/real_build/stage2_07_micro_usb_cord_connected_to_breadboard_pico2.jpg

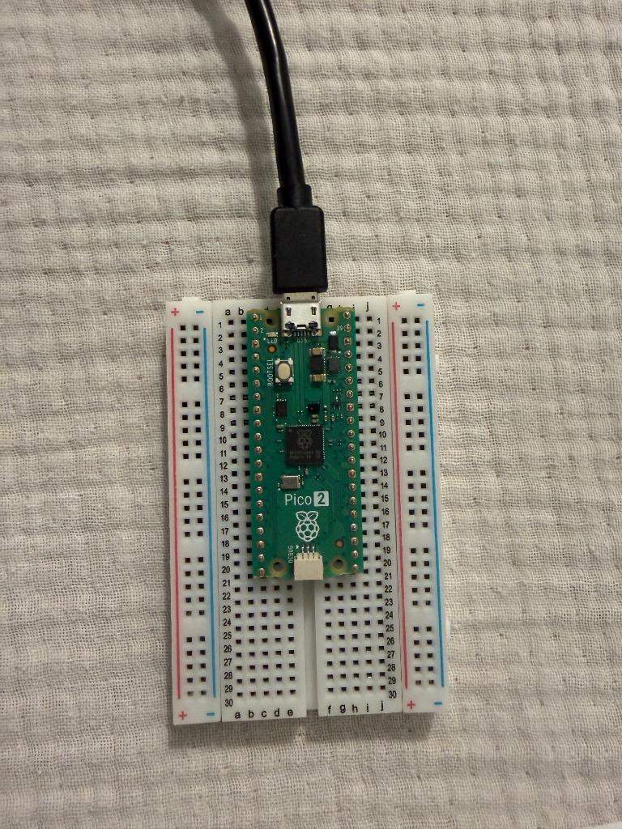
pi-diode-trailcam/docs/images/real_build/stage2_07_micro_usb_cord_connected_to_breadboard_pico2.jpg
