arctic-trail/arctic-trail-cam/pi-diode-trailcam/docs/images/real_build/stage2_08_sandisk_64gb_microsd_and_adapter.jpg

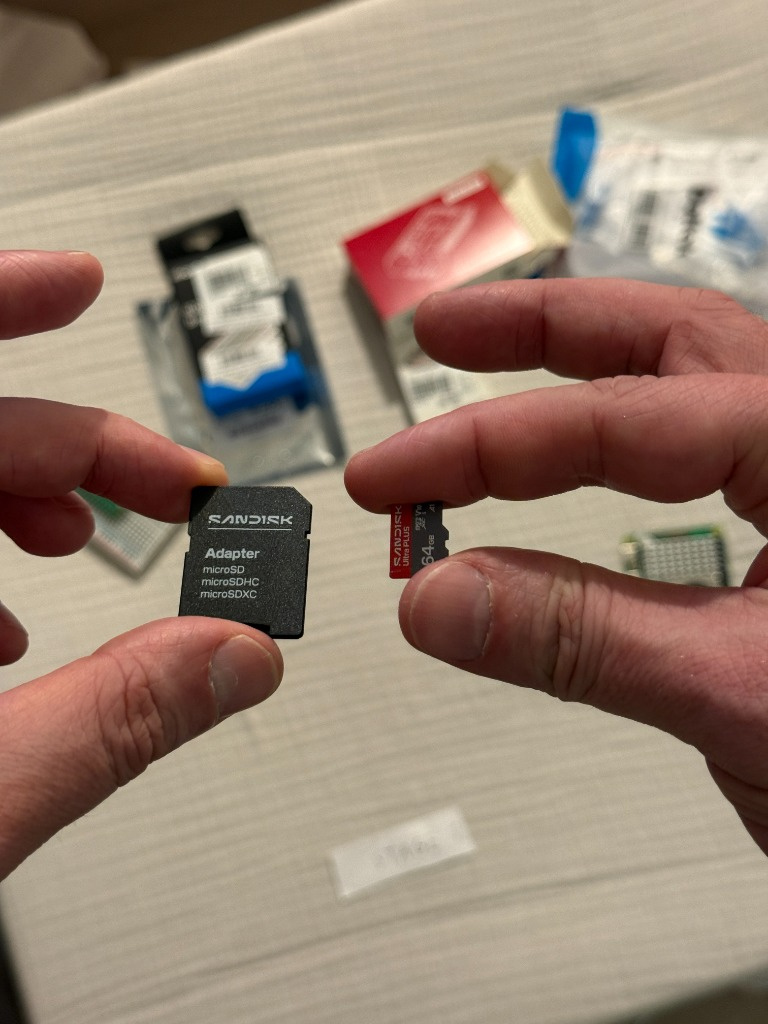
pi-diode-trailcam/docs/images/real_build/stage2_08_sandisk_64gb_microsd_and_adapter.jpg
