arctic-trail/arctic-trail-cam/pi-diode-trailcam/docs/images/real_build/stage2_09_sliding_microsd_into_adapter.jpg

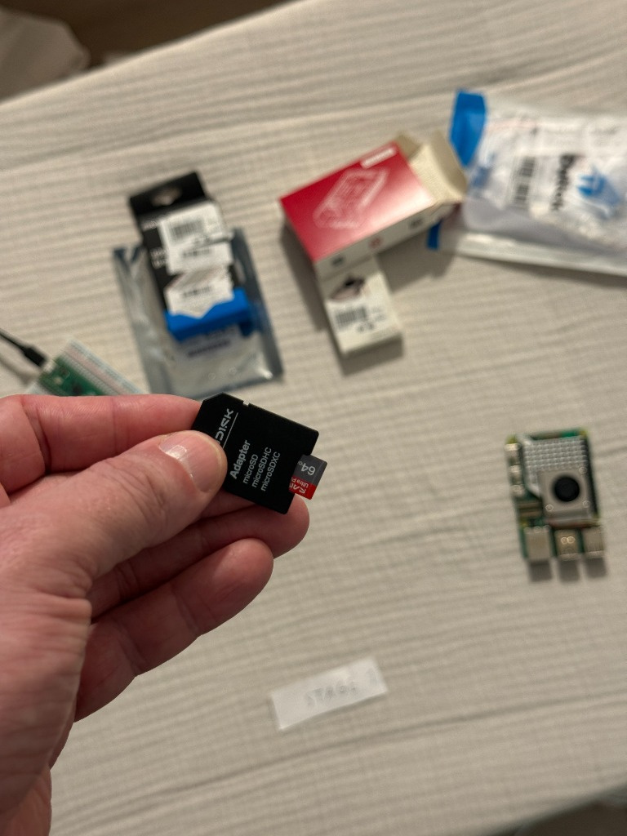
pi-diode-trailcam/docs/images/real_build/stage2_09_sliding_microsd_into_adapter.jpg
