arctic-trail/arctic-trail-cam/pi-diode-trailcam/docs/images/real_build/stage2_10_microsd_seated_flush_in_adapter.jpg

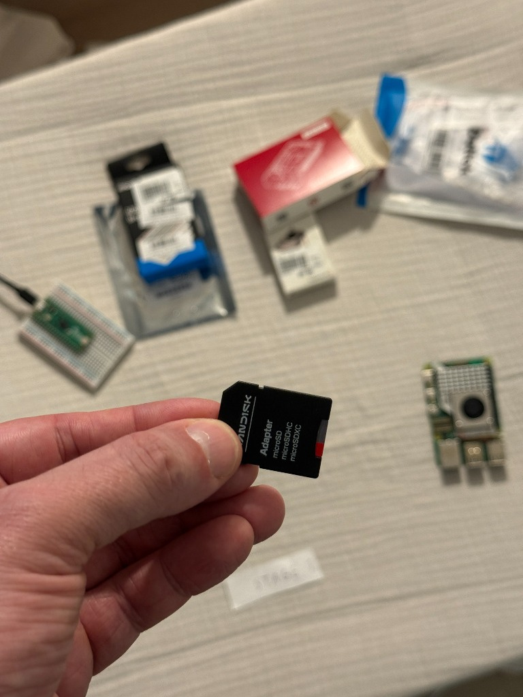
pi-diode-trailcam/docs/images/real_build/stage2_10_microsd_seated_flush_in_adapter.jpg
