arctic-trail/arctic-trail-cam/pi-diode-trailcam/docs/images/real_build/stage2_11_sd_adapter_in_macbook_pro_slot.jpg

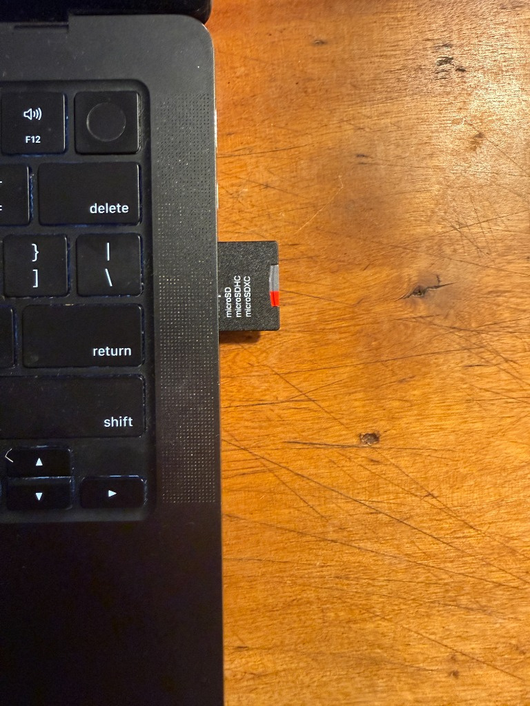
pi-diode-trailcam/docs/images/real_build/stage2_11_sd_adapter_in_macbook_pro_slot.jpg
