arctic-trail/arctic-trail-cam/pi-diode-trailcam/docs/images/real_build/stage2_12_sliding_microsd_into_pi5_underside_slot.jpg

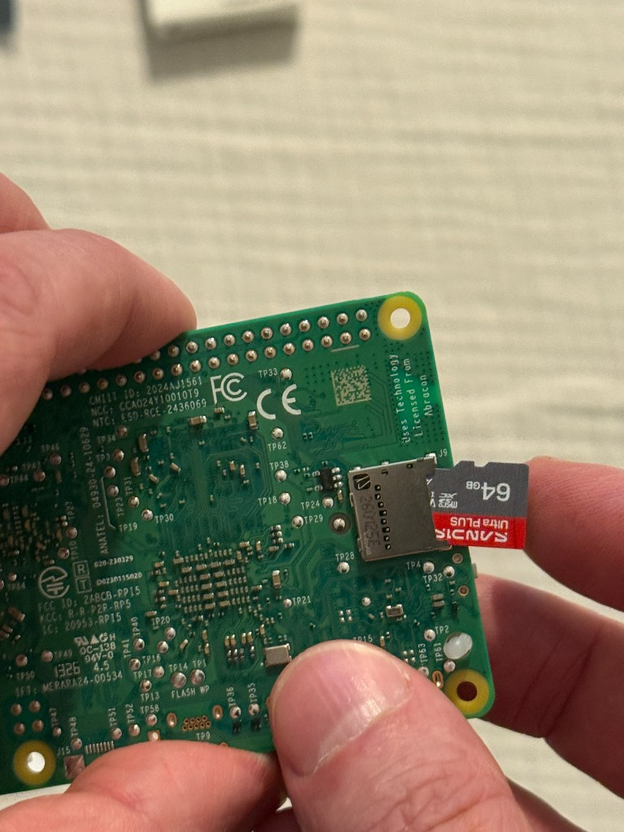
pi-diode-trailcam/docs/images/real_build/stage2_12_sliding_microsd_into_pi5_underside_slot.jpg
