arctic-trail/arctic-trail-cam/pi-diode-trailcam/docs/images/real_build/stage2_13_microsd_seated_flush_in_pi5_underside_slot.jpg

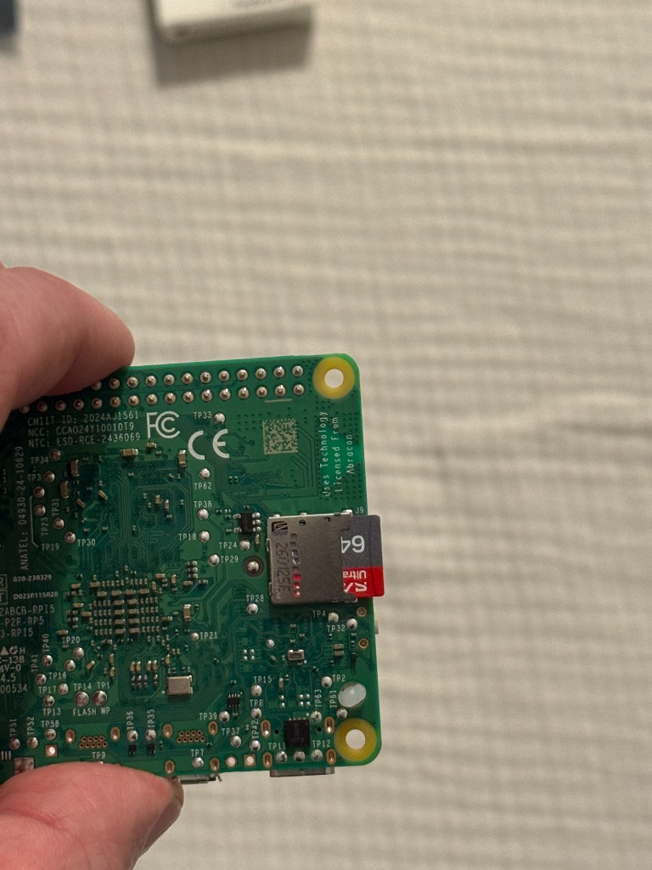
pi-diode-trailcam/docs/images/real_build/stage2_13_microsd_seated_flush_in_pi5_underside_slot.jpg
