arctic-trail/arctic-trail-cam/pi-diode-trailcam/hardware/kicad/pi-diode-carrier.kicad_pcb

## KiCad design pi-diode-trailcam/hardware/kicad/pi-diode-carrier.kicad_pcb (2026-10-16)

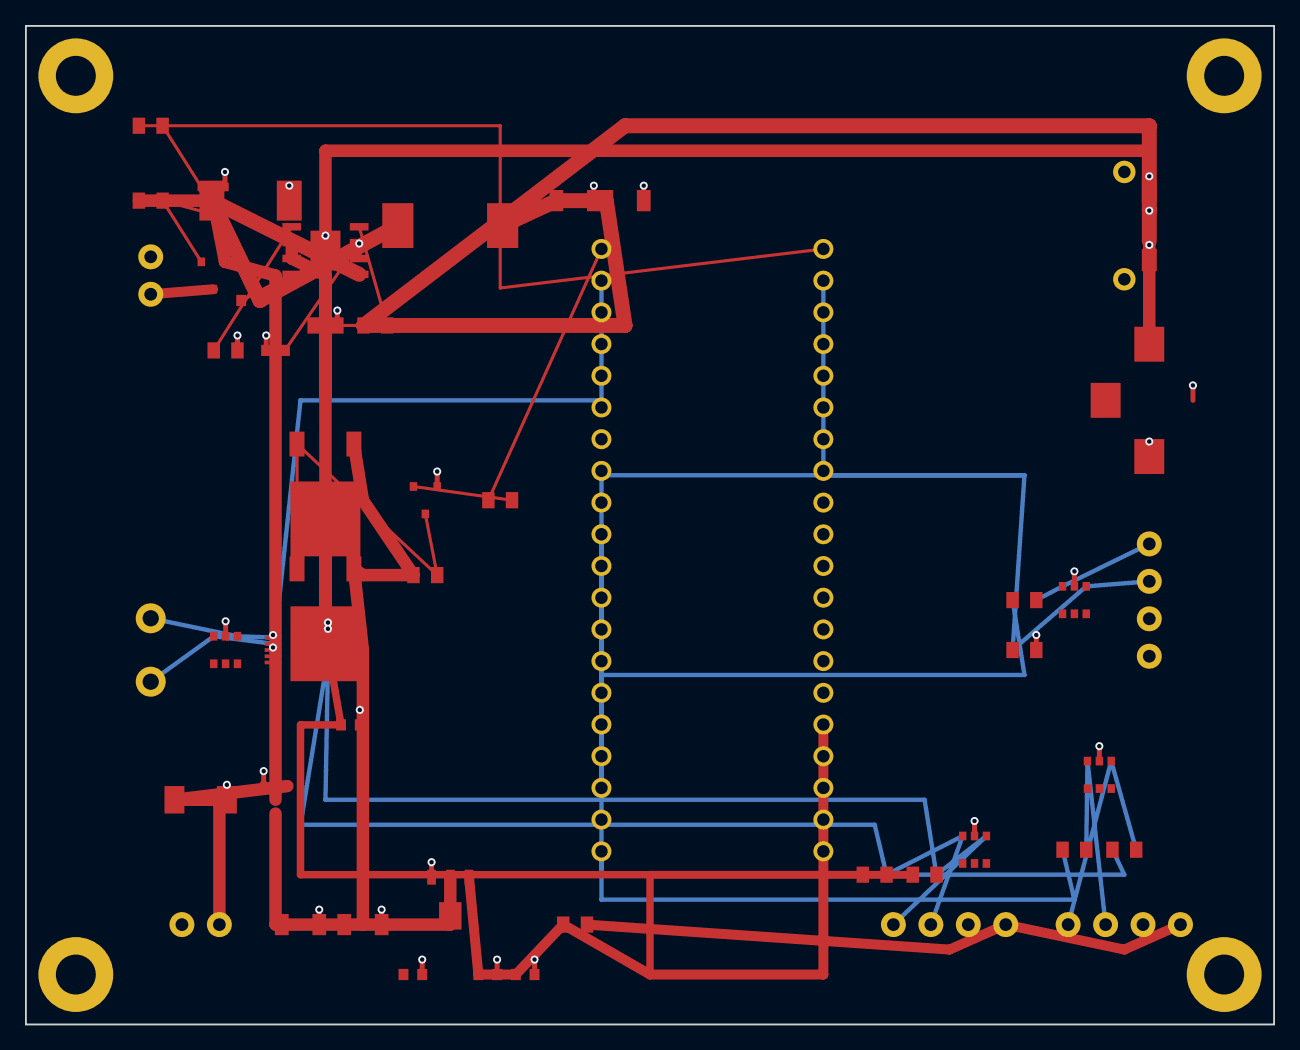
[picture p69: board pi-diode-carrier.kicad_pcb from above]

Board: 4 copper layers, 100.0 x 80.0 mm, 49 parts (0 on the bottom side), 32 nets.

Parts:
C1, C2: 10uF-50V; C_1206
C3, C4: 47uF-16V; C_1206
C5, C6, C7, C8, C9: 0.1uF-50V; C_0603
C10: 10nF-50V; C_0603
D1: SMBJ15CA; DO-214AA_SMB
D2, D3, D4, D5: USBLC6-2SC6; SOT-23-6
D6: SS54-E3; DO-214AB_SMC
FB1, FB2, FB3: 220R-2A; L_0805
J1: Micro-Fit-2P-Batt; CONN-TH_2P-P3.00mm
J2: Micro-Fit-4P-Mag; CONN-TH_4P-P3.00mm
J3: Micro-Fit-4P-Radar; CONN-TH_4P-P3.00mm
J4: Micro-Fit-4P-Pi5; CONN-TH_4P-P3.00mm
J5: USB-C-5V-5A; USB-C-SMD
J6: DC-Barrel-2.1mm; DC-005_SMD
J7: Micro-Fit-2P-Deice; CONN-TH_2P-P3.00mm
L1: 10uH-6.5A; IND-SMD_10x10mm
Q1, Q3: AO3401A; SOT-23
Q2A, Q2B: AOD403; TO-252
Q4, Q5: MMBT2222A; SOT-23
R1, R6, R7, R8: 10k-1%; R_0805
R2, R9, R10: 1k-1%; R_0805
R3, R4: 4.7k-1%; R_0805
R5: 53.6k-1%; R_0805
R11: 100k-1%; R_0805
TB1: Screw-Terminal-2P; TERM-5.08mm-2P
U1: HT7533-1; SOT-89
U2: RP2040-Pico-Socket; DIP-40
U3: TPS54560BDDAR; SOIC-8-EP
U4: ADS1115IDGSR; VSSOP-10

Connections:
+3V3_ALWAYS_ON: C5.1, C6.1, C8.1, D4.5, D5.5, FB1.1, J4.3, R3.1, R4.1, U1.3, U2.36, U2.39, U4.8
+3V3_SENSORS: D2.5, D3.5, FB1.2, J2.1, J3.1
+5V_PI5: C3.1, C4.1, J5.2, J5.4, L1.2, R5.1
+12V_BATT: C1.1, C2.1, C7.1, Q1.3, Q2A.2, Q2B.2, Q3.2, R7.1, R8.1, U1.2, U1.4
+12V_DEICE: J7.1, Q3.3
+12V_RAW: D1.1, J1.1, Q1.2
+12V_SWITCHED: J6.1, Q2A.3, Q2B.3, U3.2, U3.3
GATE_CTRL_DEICE: R10.1, U2.21
GATE_CTRL_DOMAIN_B: R9.1, U2.20
GEOPHONE_ALERT: U2.19, U4.2
GEOPHONE_N: D4.3, D4.4, TB1.2, U4.5
GEOPHONE_P: D4.1, D4.6, TB1.1, U4.4
GND: C1.2, C2.2, C3.2, C4.2, C5.2, C6.2, C7.2, C8.2, C10.1, D1.2, D2.2, D3.2, D4.2, D5.2, D6.2, J1.2, J2.2, J3.2, J4.4, J5.1, J5.3, J5.5, J5.6, J5.7, J6.2, J6.3, J7.2, Q1.1, Q4.2, Q5.2, R1.2, R6.2, R11.2, U1.1, U2.3, U2.8, U2.13, U2.18, U2.23, U2.28, U2.33, U2.38, U3.7, U3.9, U4.1, U4.3, U4.6, U4.7
I2C0_SCL: D2.3, D2.4, J2.4, R4.2, U2.7, U4.10
I2C0_SDA: D2.1, D2.6, J2.3, R3.2, U2.6, U4.9
NC: U2.5, U2.9, U2.10, U2.12, U2.14, U2.15, U2.16, U2.17, U2.24, U2.25, U2.26, U2.27, U2.29, U2.30, U2.31, U2.32, U2.34, U2.35, U2.37, U2.40
PI5_DONE: D5.3, D5.4, J4.2, R1.1, U2.4, U2.22
PI5_UART_RX: D5.1, D5.6, J4.1, R2.2
Q2_GATE: Q2A.1, Q2B.1, Q4.3, R7.2
Q3_GATE: Q3.1, Q5.3, R8.2
Q4_BASE: Q4.1, R9.2
Q5_BASE: Q5.1, R10.2
TELEMETRY_TX: R2.1, U2.11
TPS_BOOT: C9.1, U3.1
TPS_COMP: C10.2, U3.6
TPS_FB: R5.2, R6.1, U3.5
TPS_RT: R11.1, U3.4
TPS_SW: C9.2, D6.1, L1.1, U3.8
UART0_RADAR_RX: D3.1, D3.6, FB2.2, J3.3
UART0_RADAR_TX: D3.3, D3.4, FB3.2, J3.4
UART0_RX_PICO: FB3.1, U2.2
UART0_TX_PICO: FB2.1, U2.1
