arctic-trail/arctic-trail-cam/(commit log)

2026-10-16 Initial release: Arctic Trail Cam System (v0.9-beta prototype)
    [BOM-jlcpcb.csv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]
2026-10-16 Initial release: Arctic Trail Cam & Sky-Diode Relay
2026-10-16 Remediate all 21 findings from the 16 Oct 2026 project quality assessment
    [pi-diode-carrier.kicad_pcb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]
2026-10-16 Clarify Build D BOM quantity as 10 DigiKey SKUs / 20 individual part pieces for 1 TX+RX link pair
    # Conflicts:
    # sky-diode-relay.zip
2026-10-16 Fix chronological order of Stage 1 cooler push-pin & Pico 2 BOOTSEL photos in PDF & build guides
2026-10-16 Add '🇫🇮 Finnish engineering.' to README header
